mcer12/Flora-ESP8266/Resources/IV-6_V2_SCHEMATIC.pdf

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
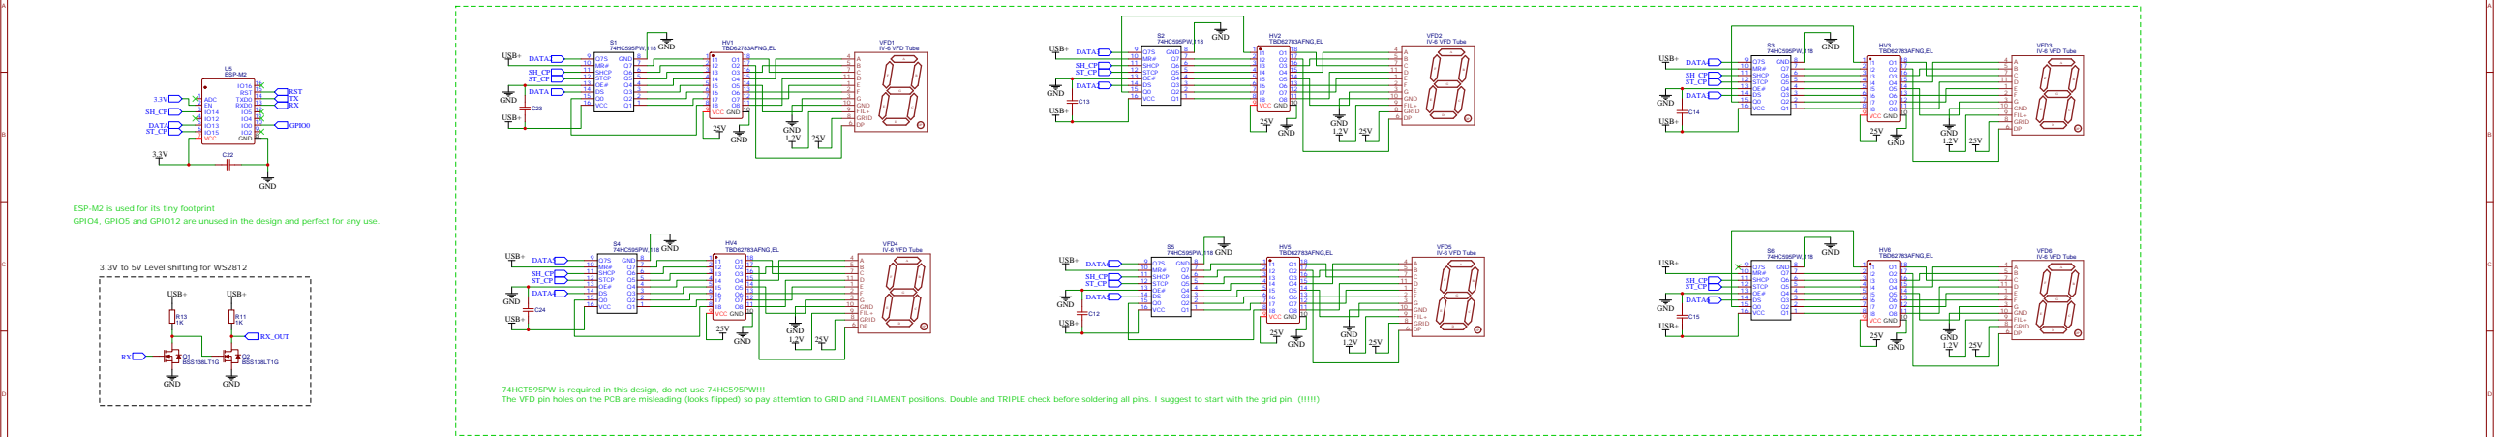
[picture p7: figure]
GND 1.2V; USB+; GND; DATA; DATA2 USB+; DATA2; DATA3; DATA4; DATA5 USB+; DATA5; DATA6; IV-6 VFD Tube; VFD1; FIL+; GRID; VFD2; VFD3; VFD4; VFD5; VFD6; ESP-M2; ADC 1 EN 2 IO14 3 IO12 4 IO13 5 IO15 6; VCC 7; GND 8; GPIO0; RST; ESP-M2 is used for its tiny footprint; TBD62783AFNG,EL; VCC; GND 8 Q7S 9 MR# 10 SHCP 11 STCP 12 OE# 13 DS 14 Q0 15 VCC 16; SHCP; STCP; 3.3V to 5V Level shifting for WS2812; BSS138LT1G; RX_OUT

IO0 10 IO4 11 IO5 12 RXD0 13 TXD0 14 RST 15

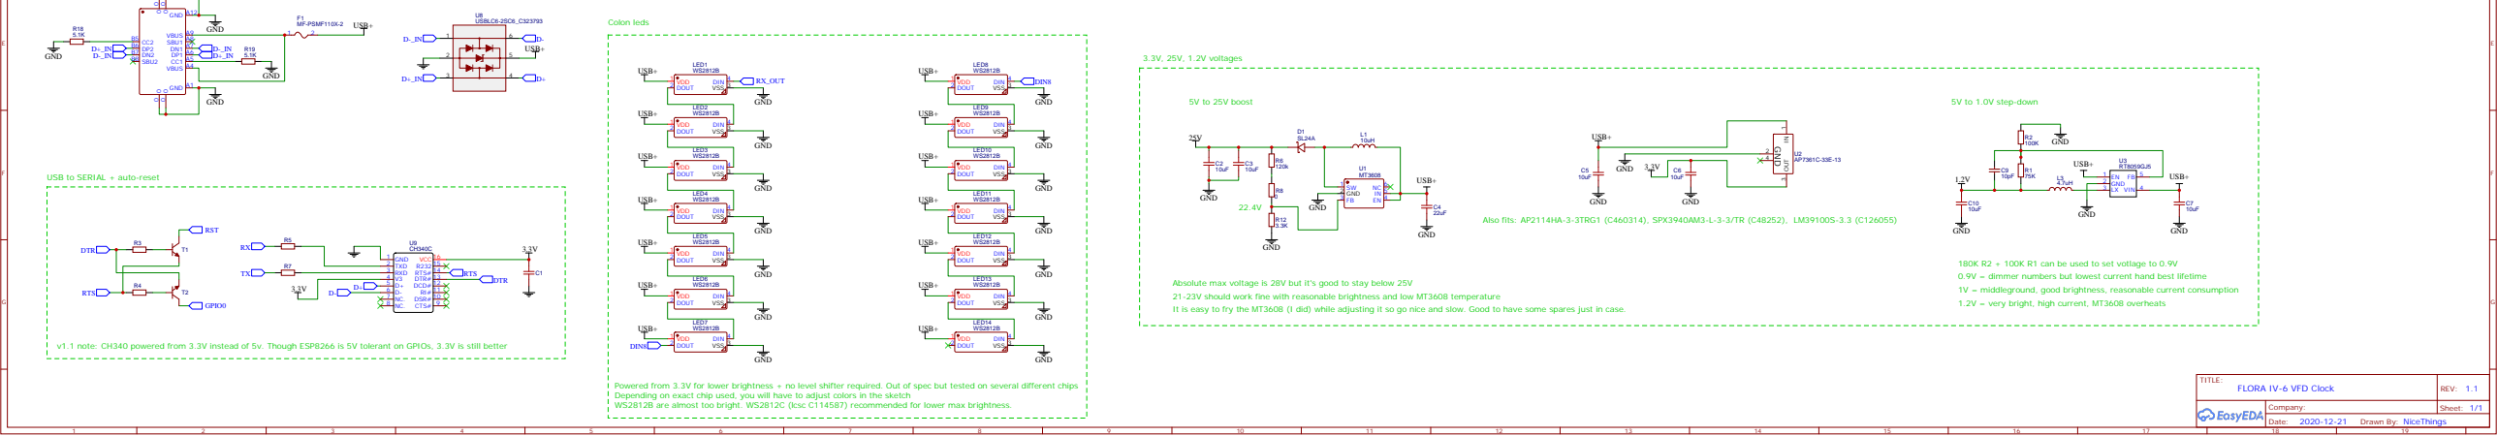
[picture p8: figure]
TITLE:; FLORA IV-6 VFD Clock; REV: 1.1; Date:; Sheet: 1/1 Drawn By: NiceThings; Company:; LED1; DIN; VSS; 3 DOUT; VDD; LED2; LED3; LED4; LED5; GND; VIN; RST; GPIO0; DTR; RTS; USB to SERIAL + auto-reset; VCC 16 R232 15 RTS# 14 DTR# 13 DCD# 12 RI# 11 DSR# 10 CTS# 9 NC. 8; RXD 3; TXD 2; GND 1; 5V to 1.0V step-down; USB+; LED6; 3.3V, 25V, 1.2V voltages; USB+ 1.2V; 5V to 25V boost; DIN8; Colon leds; CC2 B5 DP2 B6 DN2 B7 SBU2 B8; GND A1; GND A12; MF-PSMF110X-2; USBLC6-2SC6_C323793; D- USB+; LED7; LED8; LED9; LED10; LED11; LED12; LED13; LED14; RX_OUT; OUT

## Absolute max voltage is 28V but it's good to stay below 25V 21-23V should work fine with reasonable brightness and low MT3608 temperature

It is easy to fry the MT3608 (I did) while adjusting it so go nice and slow. Good to have some spares just in case.

The VFD pin holes on the PCB are misleading (looks flipped) so pay attemtion to GRID and FILAMENT positions. Double and TRIPLE check before soldering all pins. I suggest to start with the grid pin. (!!!!!)

## VFD + shift registers

## 180K R2 + 100K R1 can be used to set votlage to 0.9V

WS2812B are almost too bright. WS2812C (lcsc C114587) recommended for lower max brightness.

## Depending on exact chip used, you will have to adjust colors in the sketch

GPIO4, GPIO5 and GPIO12 are unused in the design and perfect for any use.

v1.1 note: CH340 powered from 3.3V instead of 5v. Though ESP8266 is 5V tolerant on GPIOs, 3.3V is still better

Powered from 3.3V for lower brightness + no level shifter required. Out of spec but tested on several different chips

## 0.9V = dimmer numbers but lowest current hand best lifetime 1V = middleground, good brightness, reasonable current consumption 1.2V = very bright, high current, MT3608 overheats

USB3.1C16PFSMT

USBC1

VBUS A4 CC1 A5 DP1 A6 DN1 A7 SBU1 A8 VBUS A9

Also fits: AP2114HA-3-3TRG1 (C460314), SPX3940AM3-L-3-3/TR (C48252), LM39100S-3.3 (C126055)

## 74HCT595PW is required in this design, do not use 74HC595PW!!!
