mcer12/Flora-ESP8266/Resources/IV-12_SCHEMATIC.pdf

1

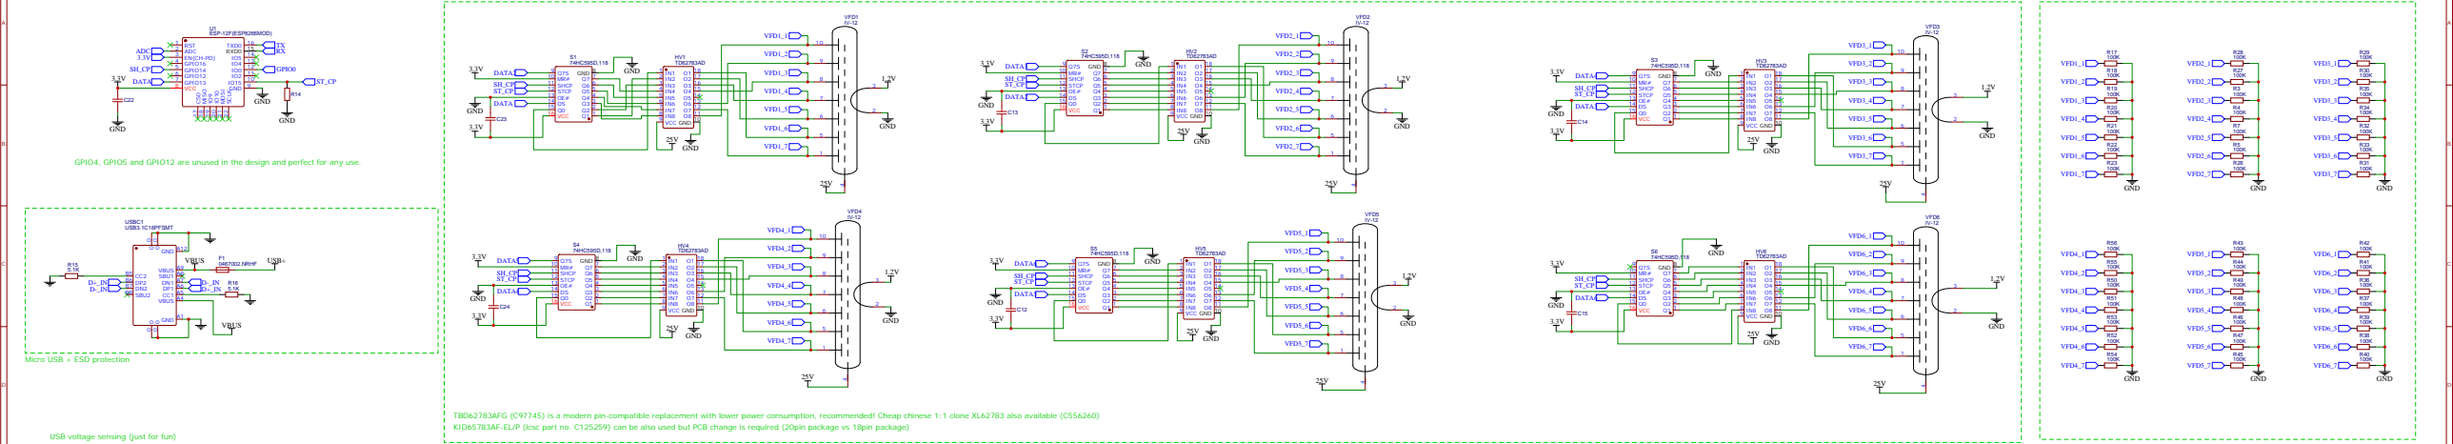
[picture p9: figure]
GND 8 Q7S 9 MR# 10 SHCP 11 STCP 12 OE# 13 DS 14 Q0 15 VCC 16; Micro USB + ESD protection; GND; SHCP; STCP; VCC; DATA; DATA2 3.3V; DATA2; DATA3; DATA4; DATA5 3.3V; DATA5; DATA6; O1 GND; VFD2; VFD1; VFD4; VFD5; VFD6; VFD3; ESP-12F(ESP8266MOD); RST 1 ADC 2 EN(CH-PD) 3 GPIO16 4 GPIO14 5 GPIO12 6 GPIO13 7; VCC 8; GND 9; MISO 18 IO9 19; MOSI 21 SCLK 22; GPIO0; VBUS; USB+; VFD3_1; VFD3_2; VFD3_3; VFD3_4; VFD3_5; VFD3_6; VFD3_7; ADC; USB voltage sensing (just for fun); VFD6_1; VFD6_2; VFD6_3; VFD6_4; VFD6_5; VFD6_6; VFD6_7; VFD5_1; VFD5_2; VFD5_3; VFD5_4; VFD5_5; VFD5_6; VFD5_7; VFD2_1; VFD2_2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
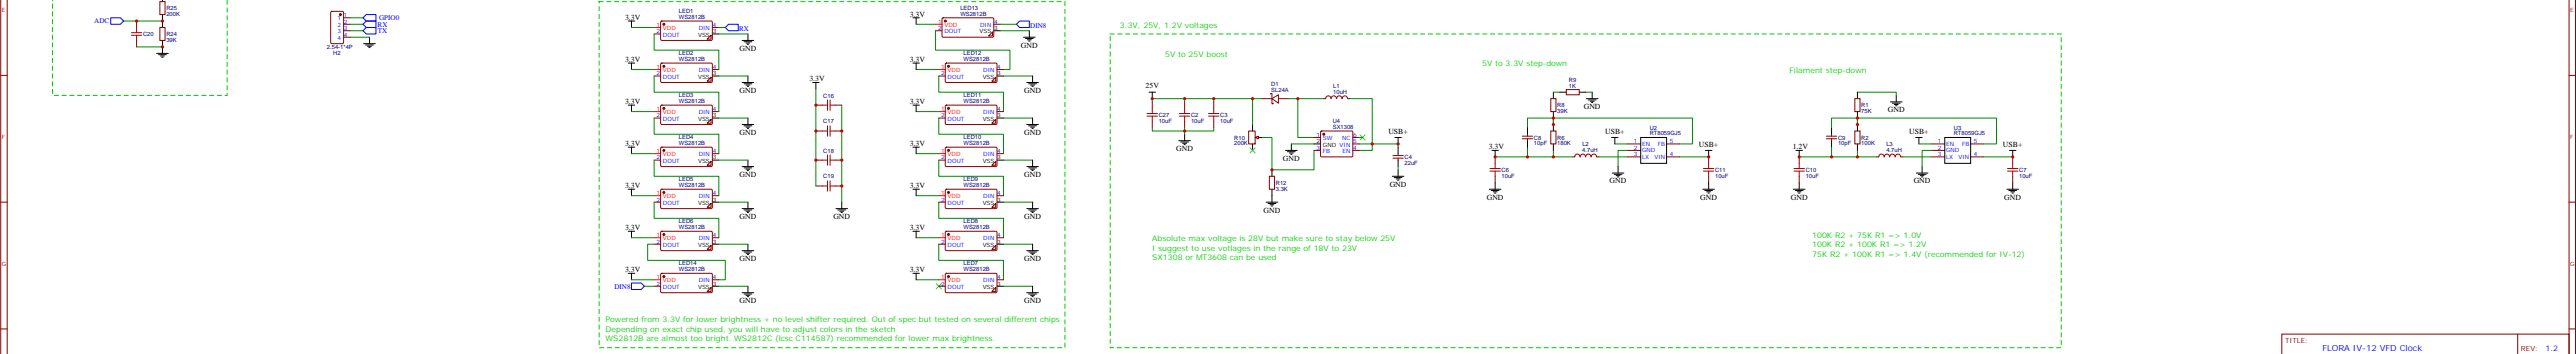
[picture p10: figure]
TITLE:; FLORA IV-12 VFD Clock; REV: 1.2; LED1; DIN; VSS; 3 DOUT; VDD; LED2; LED3; LED4; LED5; GND; VIN; Filament step-down; 5V to 3.3V step-down; LED6; USB+; 3.3V, 25V, 1.2V voltages; USB+ 1.2V; 5V to 25V boost; LED7; LED8; LED9; LED10; LED11; LED12; SX1308 or MT3608 can be used; ADC; GPIO0; DIN8; LED13; LED14

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
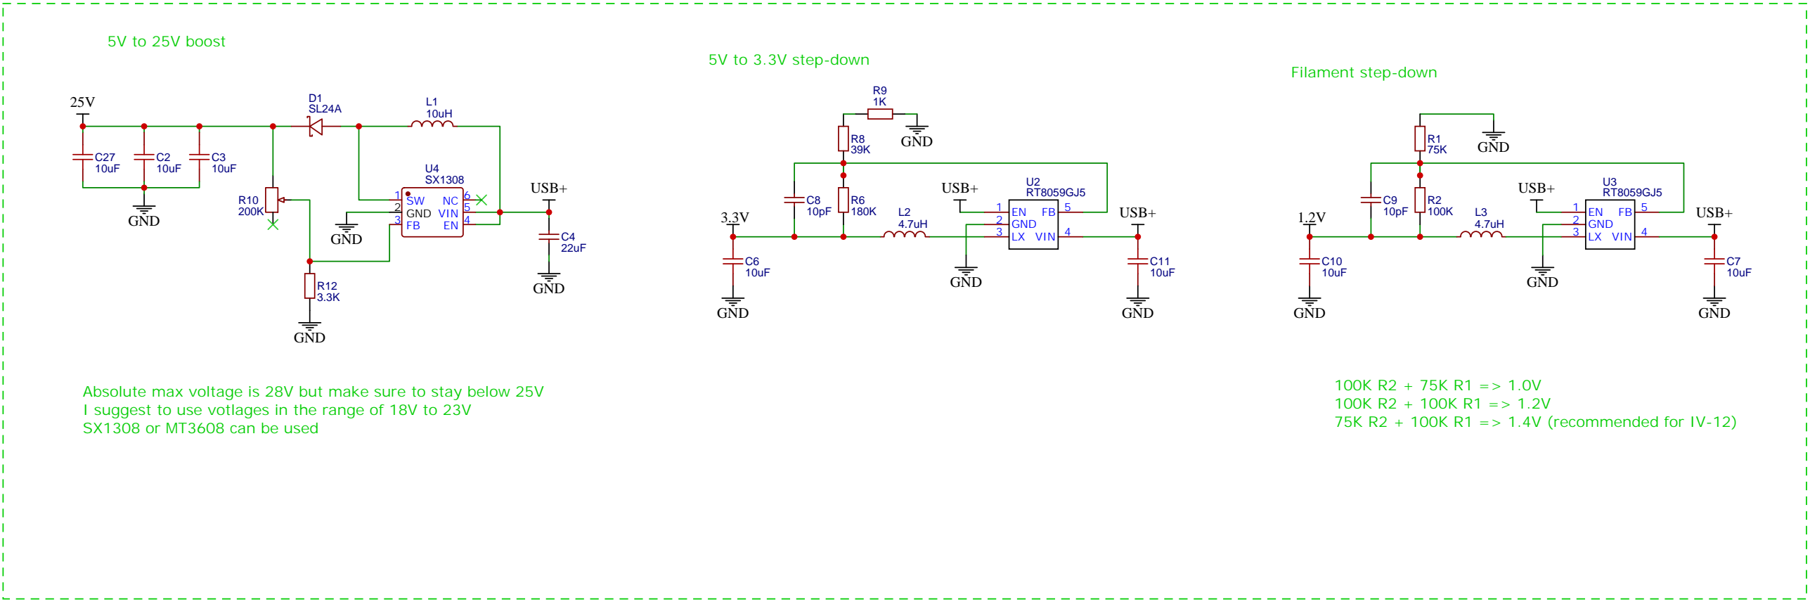
[picture p11: figure]

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
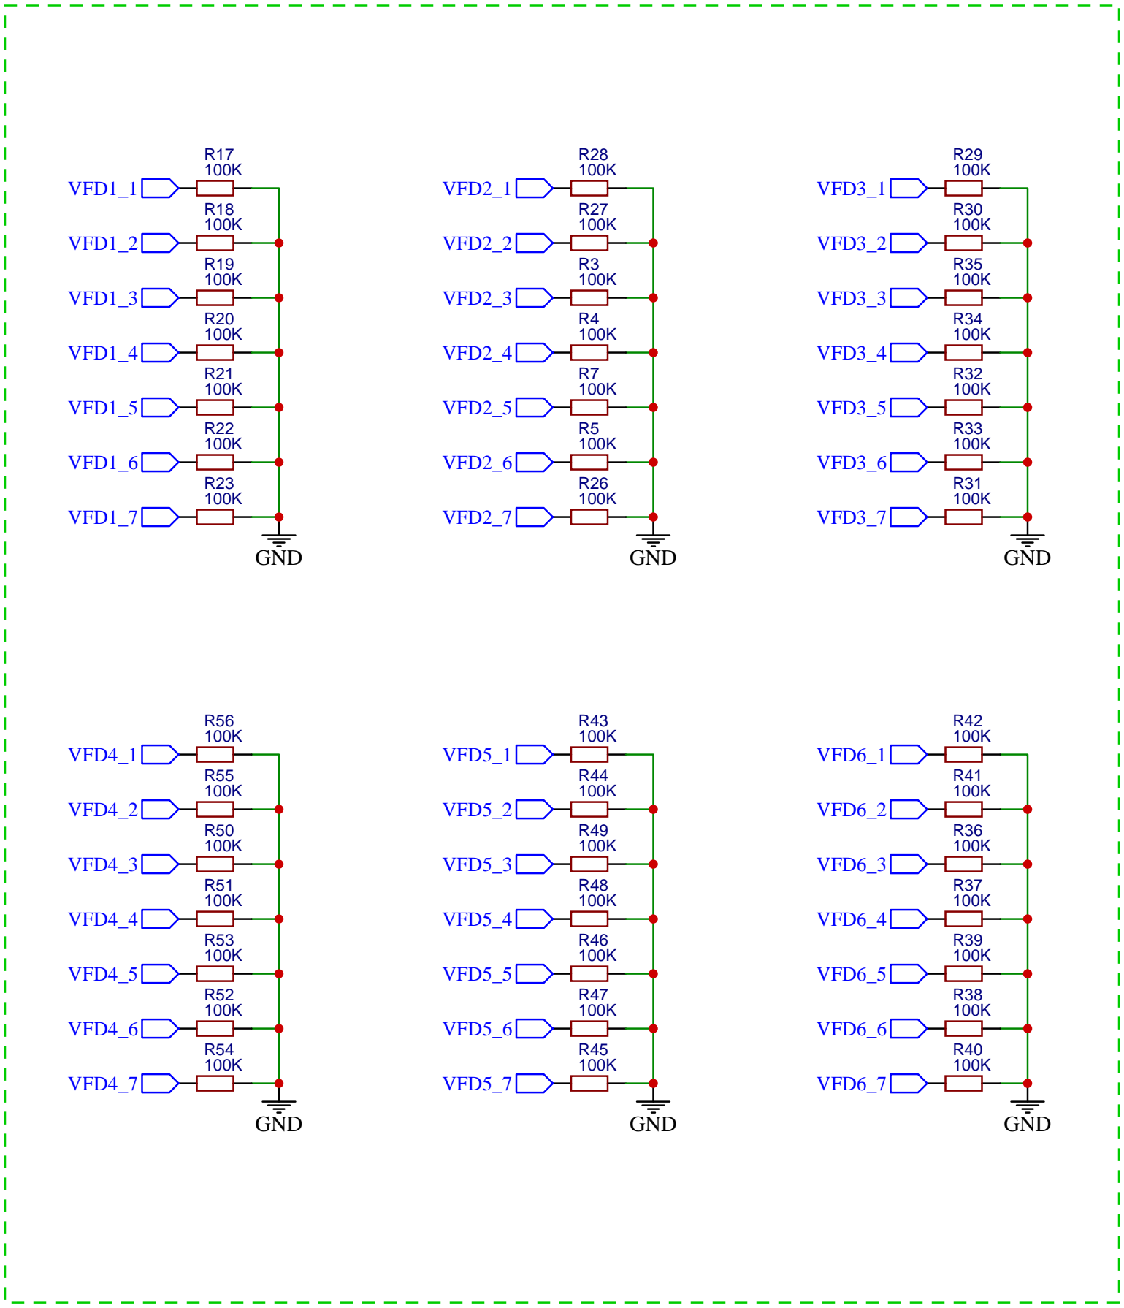
[picture p12: figure]

18

19

19

20

20

## Date: 2020-03-14

### Sheet: 1/1

## Drawn By: NiceThings

### Company:

## Colon leds

## VFD + shift registers

WS2812B are almost too bright. WS2812C (lcsc C114587) recommended for lower max brightness.

## Depending on exact chip used, you will have to adjust colors in the sketch

GPIO4, GPIO5 and GPIO12 are unused in the design and perfect for any use.

Powered from 3.3V for lower brightness + no level shifter required. Out of spec but tested on several different chips

## Absolute max voltage is 28V but make sure to stay below 25V I suggest to use votlages in the range of 18V to 23V 75K R2 + 100K R1 => 1.4V (recommended for IV-12)

IO15 10 IO2 11 IO0 12 IO4 13 IO5 14 RXD0 15 TXD0 16

KID65783AF-EL/P (lcsc part no. C125259) can be also used but PCB change is required (20pin package vs 18pin package)

TBD62783AFG (C97745) is a modern pin-compatible replacement with lower power consumption, recommended! Cheap chinese 1:1 clone XL62783 also available (C556260)

## Pulldown resistors, solder only for segments that don't turn fully off to save power

### USB+

VBUS A4 CC1 A5 DP1 A6 DN1 A7 SBU1 A8 VBUS A9
