mcer12/Flora-ESP8266/Resources/IV-22_V2_SCHEMATIC.pdf

1

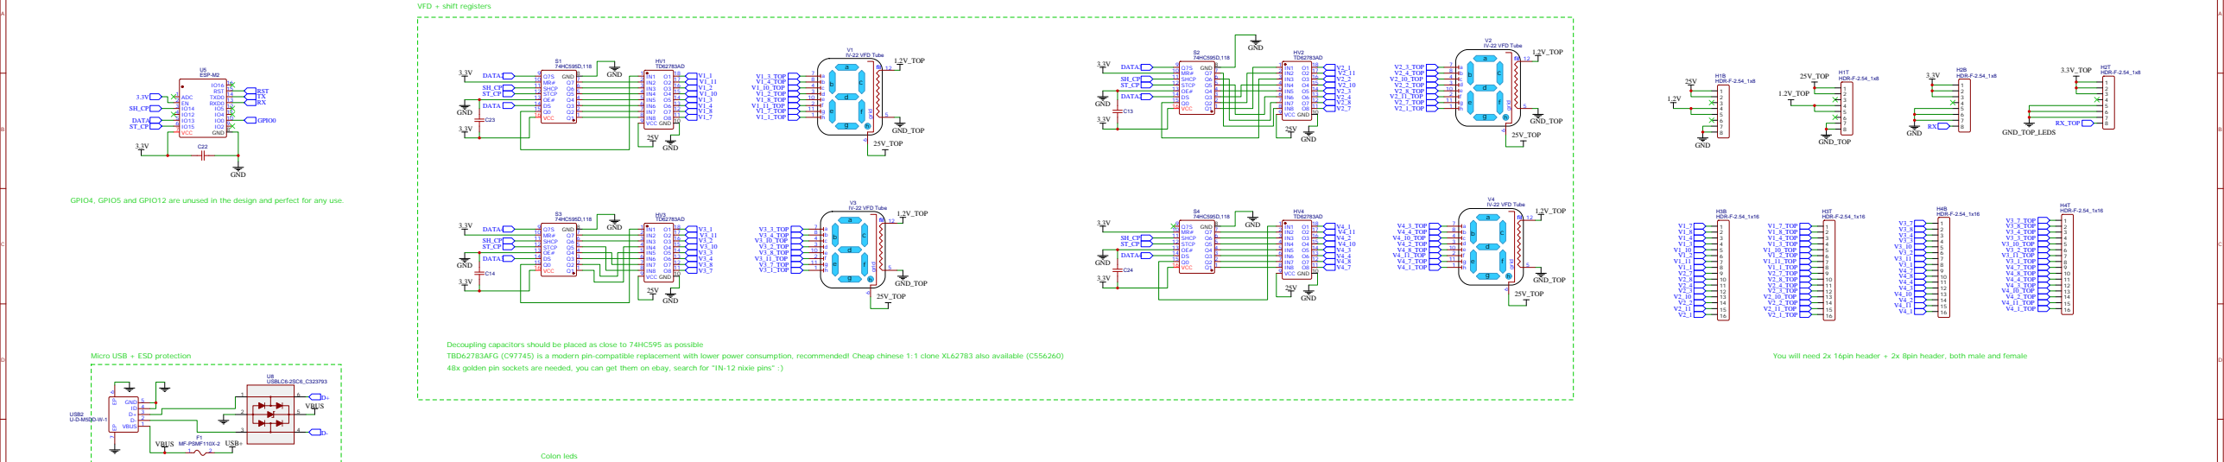
[picture p13: figure]
GND 8 Q7S 9 MR# 10 SHCP 11 STCP 12 OE# 13 DS 14 Q0 15 VCC 16; USBLC6-2SC6_C323793; Micro USB + ESD protection; USB+; GND; SHCP; STCP; VCC; DATA; DATA2 3.3V; DATA2; DATA3; DATA4 3.3V; DATA4; Colon leds; MF-PSMF110X-2; ESP-M2; ADC 1 EN 2 IO14 3 IO12 4 IO13 5 IO15 6; VCC 7; GND 8; GPIO0; RST; O1 GND; VBUS; 25V_TOP; 1.2V_TOP; GND_TOP; VFD + shift registers; IV-22 VFD Tube; grid; fil 12; USB2; VBUS 1; GND 5; HDR-F-2.54_1x8; HDR-F-2.54_1x16; V1_1_TOP; V1_11_TOP; V1_2_TOP; V1_10_TOP; V1_3_TOP; V1_8_TOP; V1_4_TOP; V1_7_TOP; V2_1_TOP; V2_11_TOP; V2_2_TOP; V2_10_TOP; V2_3_TOP; V2_4_TOP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
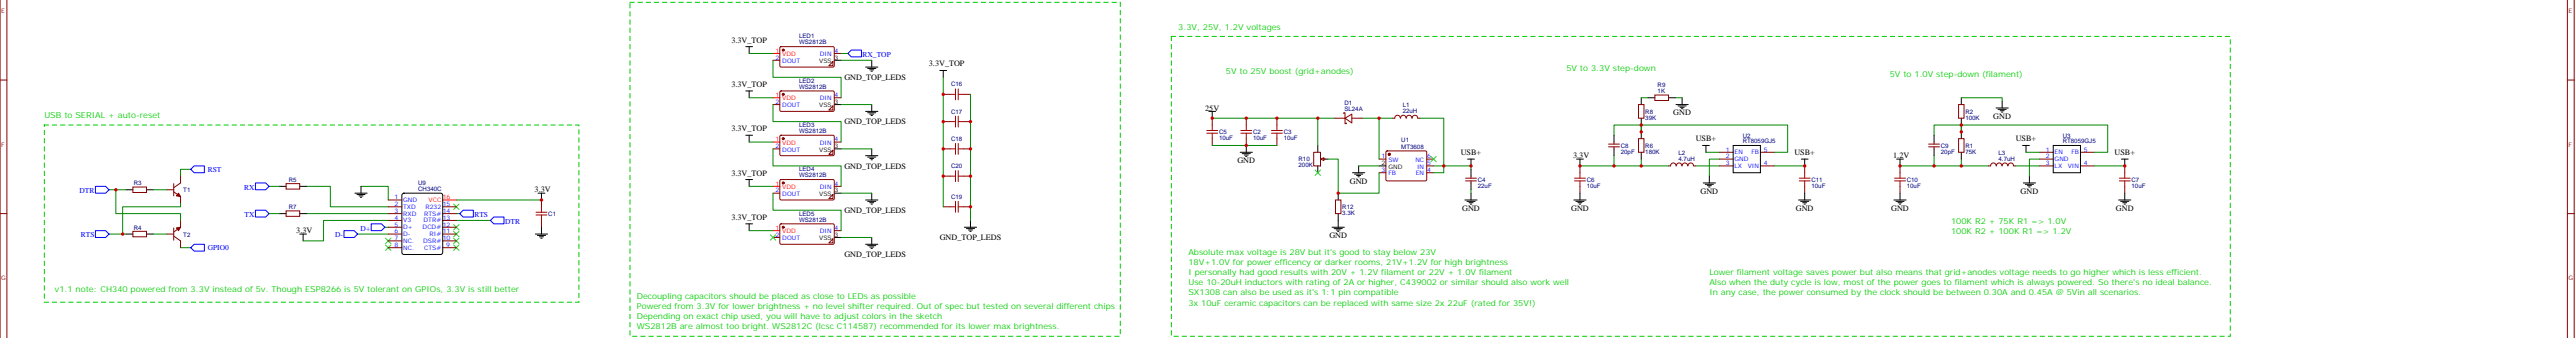
[picture p14: figure]
LED1; DIN; VSS; 3 DOUT; VDD; LED2; LED3; LED4; LED5; GND; VIN; RST; GPIO0; DTR; RTS; USB to SERIAL + auto-reset; VCC 16 R232 15 RTS# 14 DTR# 13 DCD# 12 RI# 11 DSR# 10 CTS# 9 NC. 8; RXD 3; TXD 2; GND 1; 5V to 1.0V step-down (filament); 5V to 3.3V step-down; 3.3V_TOP; GND_TOP_LEDS; RX_TOP; USB+; 3.3V, 25V, 1.2V voltages; USB+ 1.2V; 5V to 25V boost (grid+anodes)

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
TITLE:
FLORA IV-22 VFD Clock | REV: 2.0
Date: | 2021-03-09

Sheet: 1/1
Drawn By: NiceThings

Company:

IO0 10 IO4 11 IO5 12 RXD0 13 TXD0 14 RST 15

WS2812B are almost too bright. WS2812C (lcsc C114587) recommended for its lower max brightness.

Depending on exact chip used, you will have to adjust colors in the sketch

GPIO4, GPIO5 and GPIO12 are unused in the design and perfect for any use.

v1.1 note: CH340 powered from 3.3V instead of 5v. Though ESP8266 is 5V tolerant on GPIOs, 3.3V is still better Powered from 3.3V for lower brightness + no level shifter required. Out of spec but tested on several different chips

Absolute max voltage is 28V but it's good to stay below 23V
18V+1.0V for power efficency or darker rooms, 21V+1.2V for high brightness

Use 10-20uH inductors with rating of 2A or higher, C439002 or similar should also work well

TBD62783AFG (C97745) is a modern pin-compatible replacement with lower power consumption, recommended! Cheap chinese 1:1 clone XL62783 also available (C556260) | You will need 2x 16pin header + 2x 8pin header, both male and female
48x golden pin sockets are needed, you can get them on ebay, search for "IN-12 nixie pins" :)

I personally had good results with 20V + 1.2V filament or 22V + 1.0V filament

SX1308 can also be used as it's 1:1 pin compatible

Lower filament voltage saves power but also means that grid+anodes voltage needs to go higher which is less efficient. Also when the duty cycle is low, most of the power goes to filament which is always powered. So there's no ideal balance. In any case, the power consumed by the clock should be between 0.30A and 0.45A @ 5Vin all scenarios.

Decoupling capacitors should be placed as close to 74HC595 as possible

Decoupling capacitors should be placed as close to LEDs as possible 3x 10uF ceramic capacitors can be replaced with same size 2x 22uF (rated for 35V!)
