mcer12/Flora-ESP8266/Images/clock.jpg

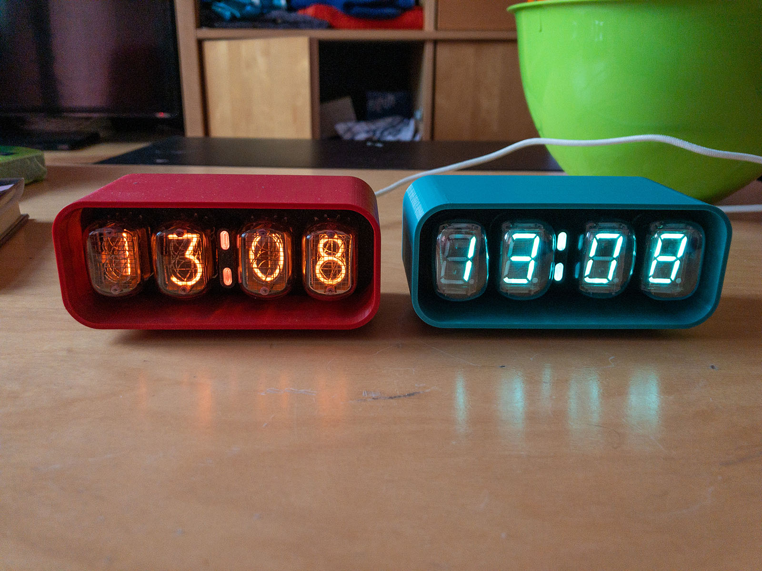
Images/clock.jpg
