mcer12/Flora-ESP8266/Images/IV22_colon_blind.jpg

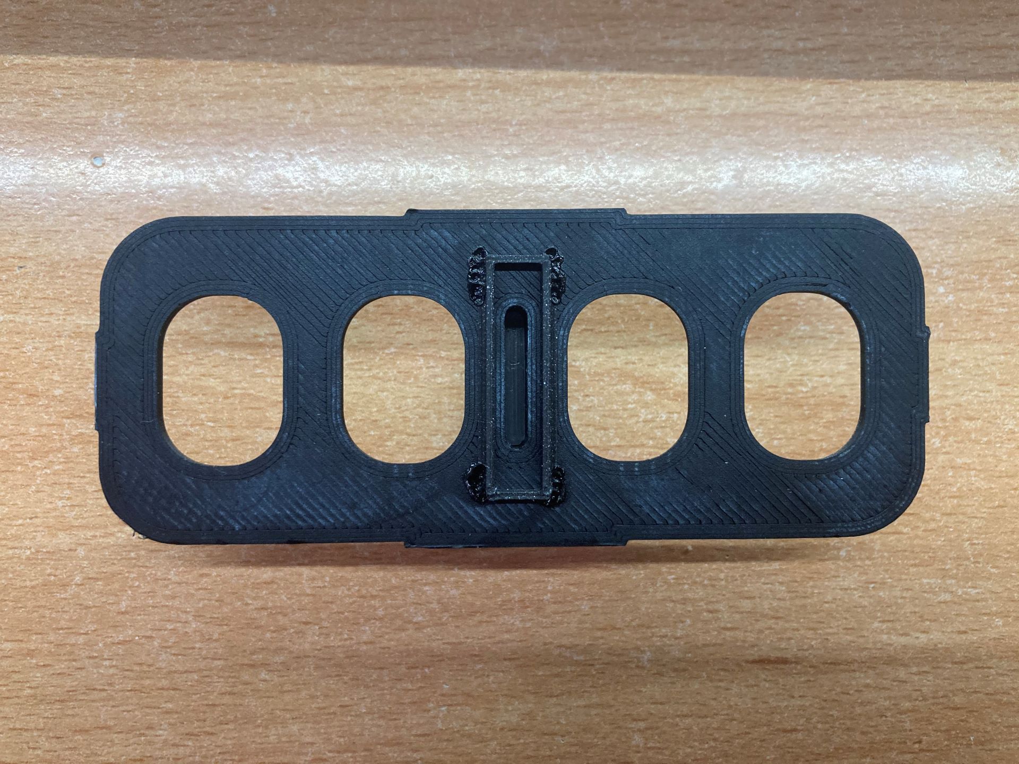
Images/IV22_colon_blind.jpg
