mcer12/Flora-ESP8266/Images/pcb_bottom.jpg

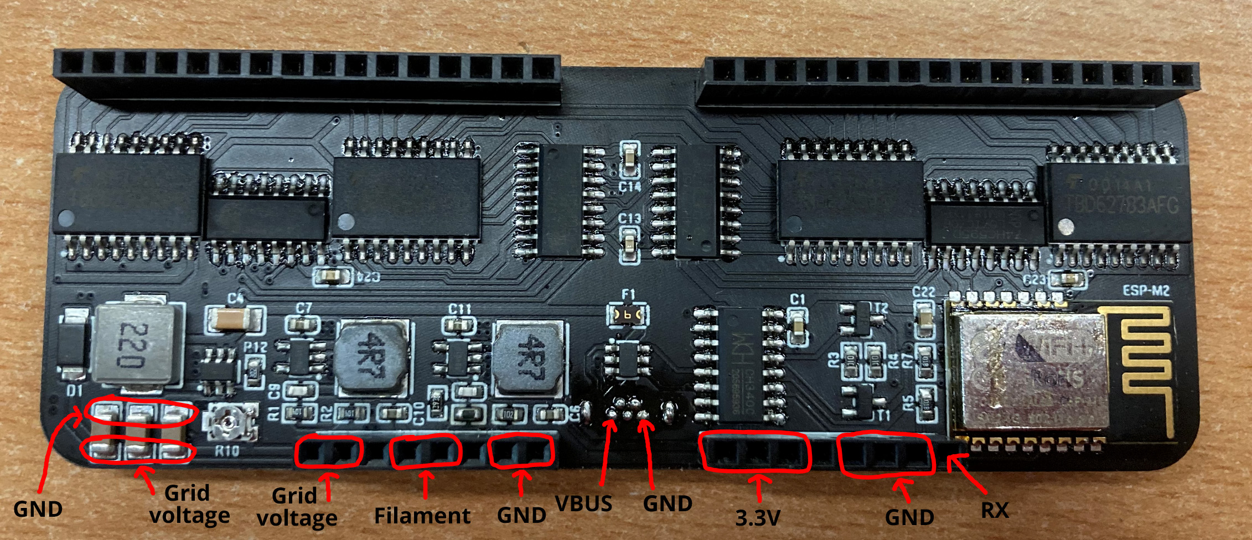
Images/pcb_bottom.jpg
