mcer12/Flora-ESP8266/Images/pcb_top.jpg

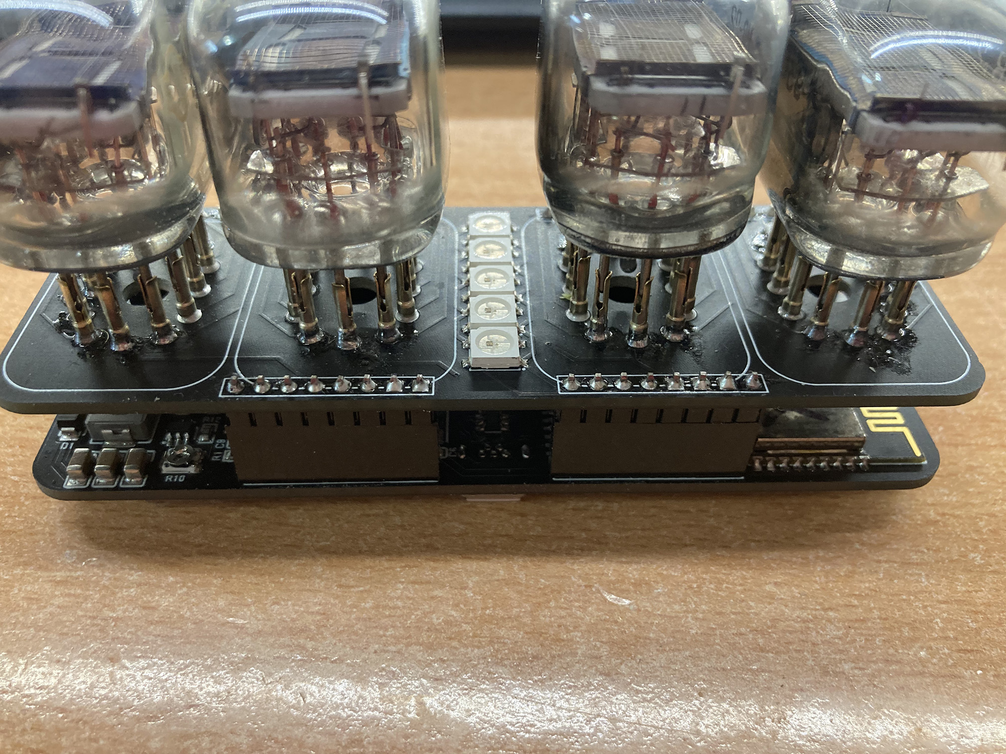
Images/pcb_top.jpg
