mcer12/Flora-ESP8266/Resources/IV-3_BOM.csv

ID | Name | Designator | Footprint | Quantity | Manufacturer Part | Manufacturer | Supplier | Supplier Part | Price
1 | 10kΩ | R11,R13,R14,R15,R16,R17,R20,R21,R22,R23,R24,R25 | R0603 | 12 | 0603WAF1002T5E | UniOhm | LCSC | C25804
2 | IV3VFD | VFD2,VFD3,VFD4,VFD5,VFD6,VFD1 | IV-3 | 6
3 | 100nF | C1,C12,C13,C14,C15,C22,C23,C24 | C0603 | 8 | CC0603KRX7R9BB104 | YAGEO | LCSC | C14663
4 | WS2812B | LED13,LED14,LED1,LED2,LED3,LED4,LED5,LED6,LED7,LED8,LED9,LED10,LED11,LED12 | LED-SMD_4P-L5.0-W5.0-TL | 14 | WS2812B | Worldsemi | LCSC | C114585
5 | MF-PSMF110X-2 | F1 | F0805 | 1 | MF-PSMF110X-2 | BOURNS | LCSC | C89658 | 0.005
6 | 5.1K | R18,R19 | R0603 | 2 | 0603WAF5101T5E | UniOhm | LCSC | C23186
7 | USB3.1C16PFSMT | USBC1 | USB-C-SMD_TYPE-C-USB-17 | 1 | - | LCSC | LCSC | C167321 | 0.059
8 | TBD62783AFNG,EL | HV1,HV2,HV3,HV4,HV5,HV6 | SSOP-18_L6.8-W4.4-P0.65-LS6.4-BL | 6 | TBD62783AFNG,EL | TOSHIBA(东芝) | LCSC | C2653777 | 0.459
9 | 74HCT595PW,118 | S1,S2,S3,S4,S5,S6 | TSSOP-16_L5.0-W4.4-P0.65-LS6.4-BL | 6 | 74HCT595PW,118 | Nexperia | LCSC | C99710 | 0.028
10 | 200K | R10 | RES-ADJ-SMD_VG039NCH | 1 | VG039NCHXTB204 | HDK | LCSC | C128551 | 0.013
11 | MT3608 | U1 | SOT-23-6_L2.9-W1.6-P0.95-LS2.8-BR | 1 | MT3608 | AEROSEMI | LCSC | C84817 | 0.014
12 | RT8059GJ5 | U2,U3 | SOT-23-5_L3.0-W1.7-P0.95-LS2.8-BR | 2 | RT8059GJ5 | RICHTEK | LCSC | C20542 | 0.029
13 | SL24A | D1 | SMA_L4.4-W2.8-LS5.4-RD | 1 | SL24A | Suzhou Good-Ark Elec | LCSC | C179543 | 0.015
14 | 10uF | C2,C3 | C1206 | 2 | CL31B106KBHNNNE | SAMSUNG | LCSC | C89632 | 0.009
15 | 22uF | C4 | C1206 | 1 | CL31A226KPHNNNE | SAMSUNG | LCSC | C5672 | 0.004
16 | 3.3K | R12 | R0603 | 1 | 0603WAF3301T5E | UniOhm | LCSC | C22978
17 | 75K | R1 | R0603 | 1 | 0603WAF7502T5E | UniOhm | LCSC | C23242
18 | 10uH | L1 | IND-SMD_L6.0-W6.0 | 1 | CR6028-100M | Ceaiya | LCSC | C520365 | 0.009
19 | 100K | R2 | R0603 | 1 | 0603WAF1003T5E | UniOhm | LCSC | C25803
20 | CH340C | U9 | SOP-16_L10.0-W3.9-P1.27-LS6.0-BL | 1 | CH340C | WCH | LCSC | C84681 | 0.077
21 | USBLC6-2SC6_C323793 | U8 | SOT-23-6_L2.9-W1.6-P0.95-LS2.8-BL | 1 | USBLC6-2SC6 | Yenji Elec | LCSC | C323793 | 0.013
22 | 1K | R9,R5,R7 | R0603 | 3 | 0603WAF1001T5E | UniOhm | LCSC | C21190
23 | 180K | R6 | R0603 | 1 | 0603WAF1803T5E | UniOhm | LCSC | C22827
24 | 10K | R4,R3 | R0603 | 2 | 0603WAF1002T5E | UniOhm | LCSC | C25804
25 | MMBT3904-C20526 | T2,T1 | SOT-23-3_L2.9-W1.3-P1.90-LS2.4-BR | 2 | MMBT3904 | CJ | LCSC | C20526 | 0.002
26 | 39K | R8 | R0603 | 1 | 0603WAF3902T5E | UniOhm | LCSC | C23153
27 | ESP-M2 | U5 | ESP-M2 | 1 | ESP-M2 | Ai-Thinker |  |  | 0.419
28 | 4.7uH | L2,L3 | IND-SMD_L6.0-W6.0 | 2 | CR6028-4R7N | Ceaiya | LCSC | C520369 | 0.009
29 | 10uF | C6,C7,C10,C11 | C0603 | 4 | CL10A106KP8NNNC | SAMSUNG | LCSC | C19702 | 0.001
30 | 10pF | C8,C9 | C0603 | 2 | CL10C100JB8NNNC | SAMSUNG | LCSC | C1634 | 0.001
