mcer12/Flora-ESP8266/Resources/IV-12_BOM.xlsx

ID | Name | Designator | Footprint | Quantity | Manufacturer Part | Manufacturer | Supplier | Supplier Part | Price | LCSC Assembly | JLCPCB SMD | Paste Type | JLCPCB Part Class
1 | 10uF | C2,C3,C27 | C1206 | 3 | CL31B106KBHNNNE | SAMSUNG | LCSC | C89632 |  |  | Yes
2 | 22uF | C4 | C1206 | 1 | CL31A226KPHNNNE | SAMSUNG | LCSC | C5672 |  |  | Yes
3 | 10uF | C6,C7,C10,C11 | C0603 | 4 | CL10A106KP8NNNC | SAMSUNG | LCSC | C19702 |  | Yes
4 | 10pF | C8,C9 | C0603 | 2 | CL10C100JB8NNNC | SAMSUNG | LCSC | C1634 |  | Yes
5 | 100nF | C12,C13,C14,C15,C16,C17,C18,C19,C20,C22,C23,C24 | C0603 | 12 | CC0603KRX7R9BB104 | YAGEO | LCSC | C14663 |  | Yes
6 | SL24A | D1 | SMA_L4.4-W2.8-LS5.4-RD | 1 | SL24A | Suzhou Good-Ark Elec | LCSC | C179543 |  | Yes | Yes
7 | 0467002.NRHF | F1 | F0603 | 1 | 0467002.NRHF | Littelfuse | LCSC | C187605 |  |  | Yes | recommend
8 | 2.54-1*4P | H2 | HDR-TH_4P-P2.54-H-M-W10.4 | 1 | 2.54-1*4P反弯排针 | BOOMELE(博穆精密) | LCSC | C91552 |  |  |  |  | Extended Part
9 | TD62783AD | HV1,HV2,HV3,HV4,HV5,HV6 | SOIC-18_L11.6-W7.5-P1.27-LS10.3-BL | 6 | TD62783AD | HTC Korea TAEJIN Tech | LCSC | C699444
10 | 10uH | L1 | IND-SMD_L8.0-W8.0_SMNR8040 | 1 | CR8040-100M | Ceaiya | LCSC | C520371
11 | 4.7uH | L2,L3 | IND-SMD_L6.0-W6.0 | 2 | CR6028-4R7N | Ceaiya | LCSC | C520369
12 | WS2812B | LED1,LED2,LED3,LED4,LED5,LED6,LED7,LED8,LED9,LED10,LED11,LED12,LED13,LED14 | LED-SMD_4P-L5.0-W5.0-TL | 14 | WS2812B | Worldsemi | LCSC | C114585
13 | 75K | R1 | R0603 | 1 | 0603WAF7502T5E | UniOhm | LCSC | C23242 |  |  | Yes
14 | 100K | R2 | R0603 | 1 | 0603WAF1003T5E | UniOhm | LCSC | C25803 |  | Yes
15 | 180K | R6 | R0603 | 1 | 0603WAF1803T5E | UniOhm | LCSC | C22827 |  | Yes
16 | 39K | R8 | R0603 | 1 | 0603WAF3902T5E | UniOhm | LCSC | C23153 |  | Yes
17 | 1K | R9 | R0603 | 1 | 0603WAF1001T5E | UniOhm | LCSC | C21190 |  | Yes
18 | 200K | R10 | RES-ADJ-SMD_VG039NCH | 1 | VG039NCHXTB204 | HDK | LCSC | C128551
19 | 3.3K | R12 | R0603 | 1 | 0603WAF3301T5E | UniOhm | LCSC | C22978 |  |  | Yes
20 | 10K | R14 | R0603 | 1 | 0603WAF1002T5E | UniOhm | LCSC | C25804 |  | Yes
21 | 5.1K | R15,R16 | R0603 | 2 | 0603WAF5101T5E | UniOhm | LCSC | C23186 |  | Yes | Yes
22 | 100K | R3,R4,R5,R7,R17,R18,R19,R20,R21,R22,R23,R26,R27,R28,R29,R30,R31,R32,R33,R34,R35,R36,R37,R38,R39,R40,R41,R42,R43,R44,R45,R46,R47,R48,R49,R50,R51,R52,R53,R54,R55,R56 | R0603 | 42 | 0603WAF1003T5E | UniOhm | LCSC | C25803 |  | Yes | Yes | base
23 | 39K | R24 | R0603 | 1 | 0603WAF3902T5E | UniOhm | LCSC | C23153 |  | Yes | Yes | base
24 | 200K | R25 | R0603 | 1 | 0603WAF2003T5E | UniOhm | LCSC | C25811 |  | Yes | Yes | base
25 | 74HC595D,118 | S1,S2,S3,S4,S5,S6 | SOIC-16_L9.9-W3.9-P1.27-LS6.0-BL | 6 | 74HC595D,118 | Nexperia | LCSC | C5947 |  | Yes
26 | ESP-12F(ESP8266MOD) | U1 | WIFIM-SMD_ESP-12F-ESP8266MOD | 1 | ESP-12F(ESP8266MOD) | Ai-Thinker | LCSC | C82891
27 | RT8059GJ5 | U2,U3 | SOT-23-5_L3.0-W1.7-P0.95-LS2.8-BR | 2 | RT8059GJ5 | RICHTEK | LCSC | C20542 |  | Yes
28 | SX1308 | U4 | SOT-23-6_L2.9-W1.6-P0.95-LS2.8-BR | 1 | SX1308 | SX | LCSC | C78162 |  |  | Yes
29 | USB3.1C16PFSMT | USBC1 | USB-C-SMD_TYPE-C-USB-17 | 1 | - | LCSC | LCSC | C167321 |  |  |  | Extended Part | Extended Part
30 | IV-12 | VFD1,VFD2,VFD3,VFD4,VFD5,VFD6 | IV-12 | 6 | IV-12 | USSR
