mcer12/Flora-ESP8266/Resources/IV-22_V2_BOM.xlsx

ID | Name | Designator | Footprint | Quantity | Manufacturer Part | Manufacturer | Supplier | Supplier Part | LCSC Assembly | JLCPCB SMD | Assembly Type | Paste Type
1 | 10uF | C2,C3,C5 | C1206 | 3 | CL31B106KBHNNNE | SAMSUNG | LCSC | C89632 |  | Yes
2 | 22uF | C4 | C1206 | 1 | CL31A226KPHNNNE | SAMSUNG | LCSC | C5672 |  | Yes
3 | 10uF | C6,C7,C10,C11 | C0603 | 4 | CL10A106KP8NNNC | SAMSUNG | LCSC | C19702 | Yes
4 | 20pF | C8,C9 | C0603 | 2 | CL10C200JB8NNNC | SAMSUNG | LCSC | C1648 | Yes | Yes | smtWeld | base
5 | 100nF | C1,C13,C14,C16,C17,C18,C19,C20,C22,C23,C24 | C0603 | 11 | CC0603KRX7R9BB104 | YAGEO | LCSC | C14663 | Yes
6 | SL24A | D1 | SMA_L4.4-W2.8-LS5.4-RD | 1 | SL24A | Suzhou Good-Ark Elec | LCSC | C179543 | Yes | Yes
7 | MF-PSMF110X-2 | F1 | F0805 | 1 | MF-PSMF110X-2 | BOURNS | LCSC | C89658 | Yes
10 | TD62783AD | HV1,HV2,HV3,HV4 | SOIC-18_L11.6-W7.5-P1.27-LS10.3-BL | 4 | TD62783AD | HTC Korea TAEJIN Tech | LCSC | C699444
11 | 22uH | L1 | IND-SMD_L7.1-W6.6 | 1 | YSPI0630A-220M | YJYCOIN | LCSC | C497873
12 | 4.7uH | L2,L3 | IND-SMD_L6.0-W6.0 | 2 | CR6028-4R7N | Ceaiya | LCSC | C520369
13 | WS2812B | LED1,LED2,LED3,LED4,LED5 | LED-SMD_4P-L5.0-W5.0-TL | 5 | WS2812B | Worldsemi | LCSC | C114585
14 | 75K | R1 | R0603 | 1 | 0603WAF7502T5E | UniOhm | LCSC | C23242 |  | Yes
15 | 100K | R2 | R0603 | 1 | 0603WAF1003T5E | UniOhm | LCSC | C25803 | Yes
16 | 10K | R3,R4 | R0603 | 2 | 0603WAF1002T5E | UniOhm | LCSC | C25804 | Yes
17 | 1K | R5,R7,R9 | R0603 | 3 | 0603WAF1001T5E | UniOhm | LCSC | C21190 | Yes
18 | 180K | R6 | R0603 | 1 | 0603WAF1803T5E | UniOhm | LCSC | C22827 | Yes
19 | 39K | R8 | R0603 | 1 | 0603WAF3902T5E | UniOhm | LCSC | C23153 | Yes
20 | 200K | R10 | RES-ADJ-SMD_VG039NCH | 1 | VG039NCHXTB204 | HDK | LCSC | C128551
21 | 3.3K | R12 | R0603 | 1 | 0603WAF3301T5E | UniOhm | LCSC | C22978 |  | Yes
22 | 74HC595D,118 | S1,S2,S3,S4 | SOIC-16_L9.9-W3.9-P1.27-LS6.0-BL | 4 | 74HC595D,118 | Nexperia | LCSC | C5947 | Yes
23 | MMBT3904-C20526 | T1,T2 | SOT-23-3_L2.9-W1.3-P1.90-LS2.4-BR | 2 | MMBT3904 | CJ | LCSC | C20526 | Yes
24 | MT3608 | U1 | SOT-23-6_L2.9-W1.6-P0.95-LS2.8-BR | 1 | MT3608 | AEROSEMI | LCSC | C84817 | Yes
25 | RT8059GJ5 | U2,U3 | SOT-23-5_L3.0-W1.7-P0.95-LS2.8-BR | 2 | RT8059GJ5 | RICHTEK | LCSC | C20542 | Yes
26 | ESP-M2 | U5 | ESP-M2 | 1 | ESP-M2 | Ai-Thinker
27 | USBLC6-2SC6_C323793 | U8 | SOT-23-6_L2.9-W1.6-P0.95-LS2.8-BL | 1 | USBLC6-2SC6 | Yenji Elec | LCSC | C323793 | Yes
28 | CH340C | U9 | SOP-16_L10.0-W3.9-P1.27-LS6.0-BL | 1 | CH340C | WCH | LCSC | C84681 | Yes
29 | U-D-M5DD-W-1 | USB2 | MICRO-USB-TH_MICRO-USB-A14 | 1 | U-D-M5DD-W-1 | HRO | LCSC | C145795
30 | HDR-F-2.54_1x8 | H1B,H2B | HDR-F-2.54_1X8 | 2 |  |  | LCSC | C225505
31 | HDR-F-2.54_1x16 | H3B,H4B | HDR-F-2.54_1X16 | 2 |  |  | LCSC | C66987
32 | HDR-M-2.54_1x8 |  |  | 2
33 | HDR-M-2.54_1x16 |  |  | 2
