mcer12/Flora-ESP8266/(threads)

Thread 1 (2021-03-06):

Separate brightness settings for each tube

mcer12, 2021-03-06:
This helps matching used tubes with different levels of burn-out.

mcer12, 2021-05-07:
Done.

Closed 2021-05-07.

Thread 3 (2021-03-08):

PWM phase shift

mcer12, 2021-03-08:
PWM is switching the high voltage current from quite high to zero very fast and this causes audible hum (on brightness below 100%). Shifting PWM cycle for each digit by few steps will smoothen the output current and help with transcient response of the booster. After this is implemented, the current should be pretty much the same throughout the duty cycle.

mcer12, 2021-03-18:
Done.

Closed 2021-03-18.

Thread 4 (2021-03-09):

Throwing exception at launch

geoffreyheller, 2021-03-09:
Cool project!

I have built the Flora 1.0 (yes I know there's a newer one coming, but I had already ordered the boards and parts earlier).  When I compile and upload the github code I get an exception thrown at launch.

I have narrowed this down to some problem with the NeoPixel strip library.  If I comment out all the strip calls, the wifi starts up and I get the website where I can configure the wifi ssid, password, and display information.

I am wondering if I am building with a different set of libraries than you?  Or perhaps my compile options are different than yours?

Can you please provide a list of the specific library versions you are using?

Here are my settings from the Arduino IDE:
Board: Generic ESP8285 Module
Builtin Led: 2
CPU Frequency: 80 Mhz
Crystal Freq: 26 Mhz
Flash size:  2MB (FS:64KB OTA~992KB)
Reset Method: dtr (aka nodemcu)
IwIP Variant: v2 Lower Memory
VTables: Flash
Exceptions: Legacy
SSL: All SSL ciphers (most compatible)

And here's the header for the exception I'm seeing on the serial monitor:
```
ets Jan  8 2013,rst cause:2, boot mode:(3,6)

load 0x4010f000, len 3584, room 16
tail 0
chksum 0xb0
csum 0xb0
v2843a5ac
~ld

SDK:2.2.2-dev(38a443e)/Core:2.7.3-3-g2843a5ac=20703003/lwIP:STABLE-2_1_2_RELEASE/glue:1.2-30-g92add50/BearSSL:5c771be
SPIFFSImpl: allocating 512+240+1400=2152 bytes
SPIFFSImpl: mounting fs @1f0000, size=b000, block=1000, page=100
SPIFFSImpl: mount rc=0

SPIFFS_close: fd=1
SPIFFS_close: fd=1
SETTINGS: No credentials set, going to config mode.
Fatal exception 0(IllegalInstructionCause):
epc1=0x40209268, epc2=0x00000000, epc3=0x00000000, excvaddr=0x00000000, depc=0x00000000

```
The above exception is thrown at line 30 of config_portal at the call to WiFi.mode(WIFI_AP);
Decoding the exception it appears to be a SPI error

One more Q:  Why is PixelCount set to 12 when there are five on the board?

Thank you!
-G.

mcer12, 2021-03-09:
Hi, first thing I see is that flash size is wrong, it should be 1M + 64SPIFFS for ESP-M2 (unless you designed your own board with different module ;) ) Another thing is that this sketch relies heavily on very fast timing, so definitely set CPU frequency to 160Mhz.
I use neopixel library 2.5.7, I will update to latest but I doubt that to be the culprit.

mcer12, 2021-03-09:
Pixel count is set to 12 because the 6 digit version has 12 leds :) The ESP has no way of knowing how many leds there really are so it doesn't make any difference.

geoffreyheller, 2021-03-09:
Ok I have set my flash size to 1M + 64SPIFFS as per the above and have also set the CPU freq to 160Mhz.

I am compiling with the following libraries:
NeoPixelBus by Makuna version 2.5.7
Time by Michael Margolis version 1.6.0
Ticker by Stefan Staub version 4.1.0
Timezone by Jack Christensen version 1.2.4 (note that this produces a compiler warning as it is targeted for AVR arch.  Possibly want to replace this with Timezone_Generic)

I am still seeing the exception happening.  Here's the exception decoded from the stack trace:

```
Exception 0: Illegal instruction
PC: 0x40209268: SPIClass::transfer(unsigned char) at C:\Users\Geoffrey\AppData\Local\Arduino15\packages\esp8266\hardware\esp8266\2.7.4\libraries\SPI\SPI.cpp line 308
EXCVADDR: 0x00000000

Decoding stack results
0x40220b0b: __swbuf_r at /home/earle/src/esp-quick-toolchain/repo/newlib/newlib/libc/stdio/wbuf.c line 82
0x401002cf: TimerHandler() at C:\Users\Geoffrey\Documents\PlatformIO\Flora-ESP8266\Firmware\FLORA_FIRMWARE/VFD_fns.ino line 50
0x40100418: timer1_isr_handler(void*) at C:\Users\Geoffrey\AppData\Local\Arduino15\packages\esp8266\hardware\esp8266\2.7.4\cores\esp8266\core_esp8266_timer.cpp line 36
0x40100460: timer1_isr_handler(void*) at C:\Users\Geoffrey\AppData\Local\Arduino15\packages\esp8266\hardware\esp8266\2.7.4\cores\esp8266\core_esp8266_timer.cpp line 43
0x4010135c: umm_malloc(size_t) at C:\Users\Geoffrey\AppData\Local\Arduino15\packages\esp8266\hardware\esp8266\2.7.4\cores\esp8266\umm_malloc\umm_malloc.cpp line 552
0x4020f4fa: String::toUpperCase() at C:\Users\Geoffrey\AppData\Local\Arduino15\packages\esp8266\hardware\esp8266\2.7.4\cores\esp8266\WString.cpp line 811
0x40101411: umm_realloc(void*, size_t) at C:\Users\Geoffrey\AppData\Local\Arduino15\packages\esp8266\hardware\esp8266\2.7.4\cores\esp8266\umm_malloc\umm_malloc.cpp line 586
0x40100f28: get_poisoned(void*, size_t) at C:\Users\Geoffrey\AppData\Local\Arduino15\packages\esp8266\hardware\esp8266\2.7.4\cores\esp8266\umm_malloc/umm_poison.c line 117
0x40101629: umm_poison_realloc_fl(void*, size_t, char const*, int) at C:\Users\Geoffrey\AppData\Local\Arduino15\packages\esp8266\hardware\esp8266\2.7.4\cores\esp8266\umm_malloc/umm_local.c line 140
0x40100fee: check_poison_neighbors(uint16_t) at C:\Users\Geoffrey\AppData\Local\Arduino15\packages\esp8266\hardware\esp8266\2.7.4\cores\esp8266\umm_malloc/umm_local.c line 59
0x401010f9: umm_malloc_core(size_t) at C:\Users\Geoffrey\AppData\Local\Arduino15\packages\esp8266\hardware\esp8266\2.7.4\cores\esp8266\umm_malloc\umm_malloc.cpp line 458
0x401003e5: __wrap_spi_flash_read(uint32_t, uint32_t*, size_t) at C:\Users\Geoffrey\AppData\Local\Arduino15\packages\esp8266\hardware\esp8266\2.7.4\cores\esp8266\core_esp8266_phy.cpp line 309
0x40100f28: get_poisoned(void*, size_t) at C:\Users\Geoffrey\AppData\Local\Arduino15\packages\esp8266\hardware\esp8266\2.7.4\cores\esp8266\umm_malloc/umm_poison.c line 117
0x402098bf: ESP8266WiFiGenericClass::mode(WiFiMode, WiFiState*) at C:\Users\Geoffrey\AppData\Local\Arduino15\packages\esp8266\hardware\esp8266\2.7.4\libraries\ESP8266WiFi\src\ESP8266WiFiGeneric.cpp line 432
0x4020e549: String::invalidate() at C:\Users\Geoffrey\AppData\Local\Arduino15\packages\esp8266\hardware\esp8266\2.7.4\cores\esp8266\WString.cpp line 140
0x40209e29: ESP8266WiFiGenericClass::mode(WiFiMode, WiFiState*) at C:\Users\Geoffrey\AppData\Local\Arduino15\packages\esp8266\hardware\esp8266\2.7.4\libraries\ESP8266WiFi\src\ESP8266WiFiGeneric.cpp line 468
0x402068a3: startConfigPortal() at C:\Users\Geoffrey\AppData\Local\Arduino15\packages\esp8266\hardware\esp8266\2.7.4\cores\esp8266/WString.h line 230
0x40211875: uart_write(uart_t*, char const*, size_t) at C:\Users\Geoffrey\AppData\Local\Arduino15\packages\esp8266\hardware\esp8266\2.7.4\cores\esp8266\uart.cpp line 509
0x4020cf4c: HardwareSerial::write(unsigned char const*, unsigned int) at C:\Users\Geoffrey\AppData\Local\Arduino15\packages\esp8266\hardware\esp8266\2.7.4\cores\esp8266/HardwareSerial.h line 164
0x4020cf4c: HardwareSerial::write(unsigned char const*, unsigned int) at C:\Users\Geoffrey\AppData\Local\Arduino15\packages\esp8266\hardware\esp8266\2.7.4\cores\esp8266/HardwareSerial.h line 164
0x4020d694: Print::println() at C:\Users\Geoffrey\AppData\Local\Arduino15\packages\esp8266\hardware\esp8266\2.7.4\cores\esp8266\Print.cpp line 186
0x40208670: setup() at C:\Users\Geoffrey\Documents\PlatformIO\Flora-ESP8266\Firmware\FLORA_FIRMWARE/FLORA_FIRMWARE.ino line 267
0x4020f904: loop_wrapper() at C:\Users\Geoffrey\AppData\Local\Arduino15\packages\esp8266\hardware\esp8266\2.7.4\cores\esp8266\core_esp8266_main.cpp line 194
```
Any ideas what this might be?

mcer12, 2021-03-09:
Oh you're correct and sorry I forgot about this... I had to edit the SPI library to support ISR timer. Pull the latest github repository and copy the library to arduino libraries folder. Reopen the sketch and flash it, should work now.

It will give you duplicate SPI library warning but it should correctly take the edited one.

geoffreyheller, 2021-03-10:
The SPI library update seems to have fixed the issue.  Thanks for following up!

mcer12, 2021-03-10:
Great to hear :)

Closed 2021-03-10.

Thread 5 (2021-03-10):

PCB assembly question

geoffreyheller, 2021-03-10:
Would it be possible to include some photos of the assembled PCB in the resources directory?

So for example, I'm not certain of the orientation of the VFD modules (top vs bottom) with respect to the PCB.   It would be very helpful to see a few photos of a completed and working assembly before I go ahead and solder the VFDs in.

Thank you!

mcer12, 2021-03-10:
I've added pcb images, should be clear now :) Also added some notes for tesing voltages.
**IMPORTANT:**
Double and triple check if the headers and usb connector are orented properly! I've made this mistake several times, especially soldering the usb connector backwards :D

geoffreyheller, 2021-03-10:
Thank you!

mcer12, 2021-03-11:
Check out this:
https://github.com/mcer12/Flora-ESP8266/wiki/IV22-Assembly-notes

geoffreyheller, 2021-03-11:
Wow!   Awesome notes.

I did not expect the glass to be so misaligned from the digits.  That's
great to know before I start soldering.
-G.

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

geoffreyheller, 2021-03-11:
I'm still unclear as to which side of the board is the top and which is the
bottom with respect to the IV22 digit orientation.

It would be great if there was an additional photo showing the tubes
attached to the board in such a way that I can see the board orientation
and the decimal points.

Best Regards,
-G.

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

mcer12, 2021-03-11:
That’s easy! Short headers = down, long headers = up :)

čt 11. 3. 2021 v 6:05 odesílatel geoffreyheller <notifications@github.com>
napsal:

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

Closed 2021-03-10.

Thread 8 (2021-03-19):

Daylight savings time incorrect

geoffreyheller, 2021-03-19:
I live in a PDT time zone.  When I enable the Daylight Savings Time checkbox in the config menu my clock reads four hours different from our local time.

I suspect this is the combination:
1) Our normal PST offset is -8h (-480 in the config menu), but we are in PDT so there's a missing hour
2) The TimeChangeRule in FLORA_FIRMWARE is coded to initialize to EDT:
```
TimeChangeRule EDT = {"EDT", Last, Sun, Mar, 1, 120};  //UTC + 2 hours
TimeChangeRule EST = {"EST", Last, Sun, Oct, 1, 60};  //UTC + 1 hours
Timezone TZ(EDT, EST);
```
I suspect that this value is either not getting saved to JSON from the config menu or is not getting loaded properly.

It might also be possible that the Timezone library isn't behaving properly on the ESP8266 arch.  I get the following warning when compiling:

> WARNING: library Timezone claims to run on avr architecture(s) and may be incompatible with your current board which runs on esp8266 architecture(s).

We might want to switch to using the Timezone_Generic library

mcer12, 2021-03-19:
These are just default values, they are ignored. You have to set the timezone in Config portal and dont forget that it's in minutes, not hours ;)

mcer12, 2021-03-19:
Please double check the settings as there might be an error. And if it still doesn't seem to work correctly, please send me a screenshot of your config portal.

geoffreyheller, 2021-03-19:
Here are my timezone and dst settings.   At 11:05am PDT local time I am seeing 7:05 reading out on the clock display.

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

mcer12, 2021-03-19:
Oh it's UTC offset, not relative offset :) So it should be -420, not 60 in this case.

geoffreyheller, 2021-03-19:
Aha!  Yes that did fix it.  Thank you!

Closed 2021-03-19.

Thread 9 (2021-03-19):

Feature Request: LED brightness and pattern control

geoffreyheller, 2021-03-19:
For my v1.0 build I'm getting the entire 5-LED center column pulsing brightly once per second.

It would be nice if I could easily reduce the brightness to match the VFD output.

Also, it would be nice if we could optionally select an LED display pattern that looks more like a colon.   So perhaps three display modes such as:
1) Full column (default)
2) Top two LEDs and bottom two LEDs
3) Second and Fourth LEDs only (odd LEDs)

I'm happy to look into doing this programming if you like.

mcer12, 2021-03-19:
You will likely have to modify the color balance to your version of WS2812. You will have to tinker with the brightness and color balance with the colon plate attached. Feel free to reprogram the colon but since the light will be guided through the colon anyway, I don't see any reason for this ;)

mcer12, 2021-03-19:
You can also turn the colon off in the config portal if it's annoying

geoffreyheller, 2021-03-20:
Ok now that I have 3d printed the case I understand that the colons are a sort of light pipe.  I'm going to try printing them in clear on my SLA printer.

I still think it might be nice to be able to easily customize the color of the colons.  As you say, the color balance might vary between different WS2812's and need adjustment.

mcer12, 2021-03-21:
Yes, I thought of that but since you have to set the color for each brightness setting separately, it would get kinda bloated...

I think it's actually a bit better if you print it with FDM (I used clear PLA), it scatters the light better even when the top is not sanded. If you sand the top, it looks perfect. SLA might actually be too clear.

Closed 2021-03-20.

Thread 14 (2021-05-10):

lowest brightness fluctuation

mcer12, 2021-05-10:
barely visible but still there. WS2812 vs pwm conflict, lets see what can be done about that

mcer12, 2021-05-15:
fixed in 5.1

Closed 2021-05-15.

Thread 22 (2022-07-14):

Change the Darlington Current Driver TD62783A to TD62783AFG or even XL62783

kafisc1, 2022-07-14:
Thank's for this great project. The shortage of parts causes me concern
Do you think it is possible to change from the Darlington Current Driver TD62783A the TD62783AFG or the XL62783?
According to the data-sheets they are all pretty similar. I've attached all data-sheets.
Thank you in advance

[2007301108_HTC-Korea-TAEJIN-Tech-TD62783AD_C699444.pdf](https://github.com/mcer12/Flora-ESP8266/files/9111829/2007301108_HTC-Korea-TAEJIN-Tech-TD62783AD_C699444.pdf)
[2106062005_TOSHIBA-TD62783AFG-O-S-EL_C2762705.pdf](https://github.com/mcer12/Flora-ESP8266/files/9111830/2106062005_TOSHIBA-TD62783AFG-O-S-EL_C2762705.pdf)
[2006031010_XINLUDA-XL62783_C556260.pdf](https://github.com/mcer12/Flora-ESP8266/files/9111847/2006031010_XINLUDA-XL62783_C556260.pdf)

mcer12, 2022-07-14:
If you take a look at the schematic, there's a note about exactly this ;)

Toshiba TBD72783 should be the best option, it's modernized version of the original, little more efficient. XL72783 is a budget alternative. You can also go for the old stock TD62783 on aliexpress, I ordered those from several sellers and they aways worked fine.

Closed 2022-07-21.

Thread 23 (2023-01-12):

How to use nixie IN-12 with VFD IV-22 pcb board?

uongquocthai, 2023-01-12:
How to Use Nixie IN-12 with Flora Esp?
 I see in the attached image it can be used with nixie IN-12. Is the pcb board of the IV-22 compatible with the IN-12? How to fix it if it's not compatible.
Best regards.!
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

mcer12, 2023-01-29:
Hi, check out my project Nick2, it has IN-12 version and it fits in the case.

Closed 2023-01-29.

Thread 25 (2024-04-04):

PCB/Schematic files

harrehlah, 2024-04-04:
Hey mate,

I've been learning and playing around with kicad on my own stuff and now I am wanting to modify your design to take a daughter board to support 3x more IV3s for a temperature display in a new enclosure I have designed - am I able to get a copy of the PCB files? I'm pretty far away skill wise from being able to even replicate your design just yet.

Cheers!

technotrasher, 2024-05-13:
unfortunately the author did not provide pcb Flora-ESP8266
you will have to create the board yourself. the author has errors. It also needs improvement - to connect a time module.
if you have a pcb, could you share?

mcer12, 2024-05-13:
@technotrasher Can you elaborate on the errors?

technotrasher, 2024-05-13:
needs improvement. rare AP7361C-33E-13 - replacement for the common LD1117S33TR. ESP M-2 is a conductor between EN - 10uF - GND. 3.3V is not correct!
in config_portal.ino replace bool startServer() - void startServer(), in FLORA_FIRMWARE.ino remove the unnecessary #include <TimeLib.h>.
NeoPixelBus library is not older than 2.6.6!!!

technotrasher, 2024-05-13:
I also want to add a time module. We have frequent power outages. The watch works fine from the power bank. but there is no Internet access.

harrehlah, 2024-05-14:
> @harrehlah I will add easyeda source for IV3 momentarily, just be aware that you will have to redesign the power supply if you want to drive more tubes. It will probably require USB PD, you won't be able to drive that many tubes from simple 5V USB.

Thanks mate! I appreciate it!

technotrasher, 2024-05-14:
NeoPixelBus by Makuna v. 2.8 - "D:\Flora IV-6\FLORA_FIRMWARE\neopixel_fns.ino: In function 'void updateColonColor(RgbColor)':
D:\Flora IV-6\FLORA_FIRMWARE\neopixel_fns.ino:79:67: error: call of overloaded 'LinearBlend(RgbColor&, RgbColor, double)' is ambiguous
   79 |     colorMed = RgbColor::LinearBlend(color, RgbColor(0, 0, 0), 0.1);
      |                                                                   ^
In file included from c:\Users\technotrasher\Documents\Arduino\libraries\NeoPixelBus_by_Makuna\src/internal/NeoColors.h:34,
                 from c:\Users\technotrasher\Documents\Arduino\libraries\NeoPixelBus_by_Makuna\src/NeoPixelBus.h:38,
                 from D:\Flora IV-6\FLORA_FIRMWARE\FLORA_FIRMWARE.ino:25:"

Thread 26 (2024-11-28):

access point

guus46a, 2024-11-28:
Hello, i have esp12 and wemos programmed, but i get no access point.
Esp12 gives
14:48:07.860 -> load 0x4010f000, len 3584, room 16
14:48:07.860 -> tail 0
14:48:07.860 -> chksum 0xb0
14:48:07.860 -> csum 0xb0
14:48:07.860 -> v2843a5ac
14:48:07.860 -> ~ld
14:48:07.860 ->
14:48:07.860 -> [CONF] Failed to mount file system
14:48:07.860 -> [CONF] Failed to read config file... first run?
14:48:07.860 -> [CONF] Creating new file...
14:48:07.860 -> [CONF] Failed to open config file for writing
14:48:07.860 -> [CONF] No0, len 3584, room 16

in monitor, and wemos givves
14:52:21.959 ->  ets Jan  8 2013,rst cause:2, boot mode:(3,6)
14:52:21.959 ->
14:52:21.959 -> load 0x4010f000, len 3584, room 16
14:52:21.959 -> tail 0
14:52:21.959 -> chksum 0xb0
14:52:21.959 -> csum 0xb0
14:52:21.959 -> v2843a5ac
14:52:21.959 -> ~ld
14:52:22.000 ->
14:52:22.023 -> [CONF] No credentials set, going to config mode.

please help

mcer12, 2024-11-28:
Make sure you select to completely erase flash and also to use version 2.6.x of the esp8266 boards in arduino ide.

guus46a, 2024-11-28:
I have 2.7.4, and try to find 2.6.x but 2.7.4 can not go lower

mcer12, 2024-11-28:
Yes it was 2.7.x sorry :D 2.7.4 is a perfect version to use. Did you follow wiki?
https://github.com/mcer12/Flora-ESP8266/wiki/Firmware-and-flashing

guus46a, 2024-11-28:
I am trying  to change a working clock to get esp on it. That is difficult because it has ds3231, stc programmed ic an an ic i do not know what it is. As i use your bin than i get homepage and can set credentials but after that i can not find page anymore. I have removed the stc ic and found data, sh-cp and st-cp and thought that it should work, but i think there is more going on because vfd's show 888
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

mcer12, 2024-11-28:
Once you connect to wifi, you can only access the config portal via local IP address as mentioned on wiki.
As for trying to botch it onto the other clock, you need to understand the circuit and probably remove the original IC on the board. Just using ESP8266 and my firmware won't work, it will take quite alot of time nad I can't help you with that.

guus46a, 2024-11-28:
I have removed the ic on board and tubes are working with 74hc595n and uln2003. Seconds tube ic has 14 free for data when ic is out and also pin 11 an 12 are connected from all 595's and free when ic is out. Website is now working but tubes still light up as 888.

technotrasher, 2024-12-05:
> I am trying to change a working clock to get esp on it. That is difficult because it has ds3231, stc programmed ic an an ic i do not know what it is. As i use your bin than i get homepage and can set credentials but after that i can not find page anymore. I have removed the stc ic and found data, sh-cp and st-cp and thought that it should work, but i think there is more going on because vfd's show 888 !

I'm working on adding a ds3231 module to my watch. the board is already ready. Now all that remains is to rewrite the program itself. I did this for the watch on NIXIE. and I have ready-made solutions.

guus46a, 2024-12-05:
The only way i could solve my problen is to put an esp sync to ds in the esp and when i want to sync the clock, i put 3.3 volts on esp and clock givves right time.

mcer12, 2025-03-24:
Closing this issue as the further discussion is not really related to this project.

Closed 2025-03-24.
