mcer12/Flora-ESP8266/Firmware/VFD_DIRECT_DRIVE/config_portal.ino

/*
  void toggleConfigMode() {
  if ((batteryPercentage() > 100 || digitalRead(12) == LOW) && buttonWakeUp()) {
    deviceMode = CONFIG_MODE;
    configStartMillis = millis(); // start counter
  }
  }
*/
void startLocalConfigPortal() {
  /*
    if (MDNS.begin("nick")) {
    Serial.println("MDNS responder started");
    }
  */
  httpUpdateServer.setup(&server, update_path, update_username, update_password);
  server.on("/", handleRoot);
  server.begin();
}

void startConfigPortal() {
  configStartMillis = millis(); // start counter

  strip.ClearTo(colorConfigMode);
  strip.Show();

  String ap_name = AP_NAME + macLastThreeSegments(mac);
  IPAddress ap_ip(10, 10, 10, 1);

  WiFi.disconnect();
  WiFi.mode(WIFI_AP);
  WiFi.softAP(ap_name.c_str());
  delay(100);
  WiFi.softAPConfig(ap_ip, ap_ip, IPAddress(255, 255, 255, 0));
  IPAddress ip = WiFi.softAPIP();
  Serial.print("IP address: ");
  Serial.println(ip);
  httpUpdateServer.setup(&server, update_path, update_username, update_password);
  server.on("/", handleRoot);
  server.begin();

  unsigned int lastTest = 0;
  while (deviceMode == CONFIG_MODE) { // BLOCKING INFINITE LOOP

    time_t remainingSeconds = (CONFIG_TIMEOUT - (millis() - configStartMillis)) / 1000;

    if (millis() - configStartMillis > CONFIG_TIMEOUT) {
      WiFi.softAPdisconnect(true);
      //WiFi.mode(WIFI_STA);
      deviceMode = CONNECTION_FAIL;
      //strip.ClearTo(RgbColor(50, 0, 0));
      //strip.Show();
      return;
    }

    if (millis() > lastTest + 100) {
      int splitTime[6] = {
        (hour(remainingSeconds) / 10) % 10,
        hour(remainingSeconds) % 10,
        (minute(remainingSeconds) / 10) % 10,
        minute(remainingSeconds) % 10,
        (second(remainingSeconds) / 10) % 10,
        second(remainingSeconds) % 10,
      };
      for (int i = 0; i < 6; i++) {
        if (i < 4 && splitTime[i] == 0) {
          blankDigit(i);
          continue;
        }
        setDigit(i, splitTime[i]);
      }
      lastTest = millis();
    }

    server.handleClient();
    delay(10);
  }
}

void handleRoot() {
  if (server.args()) {

    // Turn off the nixies
    /*
      ticker.detach();
      digitalWrite(5, 0);
      digitalWrite(4, 0);
    */
    strip.ClearTo(colorConfigSave);
    strip.Show();

    if (server.hasArg("ssid")) {
      json["ssid"] = server.arg("ssid");
    }
    if (server.hasArg("pass") && server.arg("pass") == "placeholder") {
      Serial.println("password is a placeholder, skipped!");
    }
    if (server.hasArg("pass") && server.arg("pass") != "placeholder") {
      json["pass"] = server.arg("pass");
    }
    /*
      if (server.hasArg("ip")) {
      json["ip"] = server.arg("ip");
      }
      if (server.hasArg("gw")) {
      json["gw"] = server.arg("gw");
      }
      if (server.hasArg("sn")) {
      json["sn"] = server.arg("sn");
      }
    */
    if (server.hasArg("t_format")) {
      json["t_format"] = server.arg("t_format");
    }
    if (server.hasArg("zero")) {
      json["zero"] = server.arg("zero");
    }
    if (server.hasArg("bri")) {
      json["bri"] = server.arg("bri");
    }
    if (server.hasArg("nmode")) {
      json["nmode"] = server.arg("nmode");
    }
    if (server.hasArg("cathode")) {
      json["cathode"] = server.arg("cathode");
    }
    if (server.hasArg("rst_cycle")) {
      json["rst_cycle"] = server.arg("rst_cycle");
    }
    if (server.hasArg("rst_ip")) {
      json["rst_ip"] = server.arg("rst_ip");
    }
    if (server.hasArg("std_offset")) {
      json["std_offset"] = server.arg("std_offset");
    }
    if (server.hasArg("dst_enable")) {
      json["dst_enable"] = server.arg("dst_enable");
    } else {
      json["dst_enable"] = 0;
    }
    if (server.hasArg("std_week")) {
      json["std_week"] = server.arg("std_week");
    }
    if (server.hasArg("std_day")) {
      json["std_day"] = server.arg("std_day");
    }
    if (server.hasArg("std_month")) {
      json["std_month"] = server.arg("std_month");
    }
    if (server.hasArg("std_hour")) {
      json["std_hour"] = server.arg("std_hour");
    }
    if (server.hasArg("dst_offset")) {
      json["dst_offset"] = server.arg("dst_offset");
    }
    if (server.hasArg("dst_week")) {
      json["dst_week"] = server.arg("dst_week");
    }
    if (server.hasArg("dst_day")) {
      json["dst_day"] = server.arg("dst_day");
    }
    if (server.hasArg("dst_month")) {
      json["dst_month"] = server.arg("dst_month");
    }
    if (server.hasArg("dst_hour")) {
      json["dst_hour"] = server.arg("dst_hour");
    }
    saveConfig();

  }

  // BLUE THEME FOR VFD String html = "<!DOCTYPE html><html><head><meta charset=\"UTF-8\"><meta name=\"viewport\" content=\"width=device-width,initial-scale=1\"><title>NICK IN-12</title><style>html,body{margin:0;padding:0;font-size:16px;background:#333;}body,*{box-sizing:border-box;font-family:-apple-system,BlinkMacSystemFont,\"Segoe UI\",Roboto,\"Helvetica Neue\",Arial,sans-serif;}a{color:inherit;text-decoration:underline;}.wrapper{padding:30px 0;}.container{margin:auto;padding:40px;max-width:600px;color:#fff;background:#000;box-shadow:0 0 100px rgba(0,0,0,.5);border: 10px solid #444;border-radius:50px;}.row{margin-bottom:15px;}.flexrow{display:flex;justify-items:stretch;align-items:flex-start;flex-wrap:wrap;margin-left:-10px;}.col{width:25%;padding-left:10px;}h1{margin:0 0 10px 0;font-family:Arial,sans-serif;font-weight:300;font-size:2rem;}h1 + p{margin-bottom:30px;}h2{margin:30px 0 0 0;font-family:Arial,sans-serif;font-weight:300;font-size:1.5rem;}h3{font-family:Arial,sans-serif;font-weight:300;font-size:1.2rem;margin: 25px 0 10px 0;}p{font-size:.85rem;margin:0 0 20px 0;color:rgba(255,255,255,.7);}label{display:block;width:100%;margin-bottom:5px;}label+p{margin-bottom:5px;}input[type=\"text\"],input[type=\"number\"],input[type=\"password\"],select{display:inline-block;width:100%;height:42px;line-height:38px;padding:0 20px;color:#fff;border:2px solid #666;background:none;border-radius:5px;transition:.15s;box-shadow:none;outline:none;}input[type=\"text\"]:hover,input[type=\"number\"]:hover,input[type=\"password\"]:hover,select:hover{border-color:#69b6ac;}input[type=\"text\"]:focus,input[type=\"password\"]:focus,select:focus{border-color:#a5fff3;}option{color:#000;}button{display:block;width:100%;padding:10px 20px;font-size:1rem;font-weight:700;text-transform:uppercase;background:#43ffe5;border:0;border-radius:5px;cursor:pointer;transition:.15s;outline:none;}button:hover{background:#a5fff3;}.github{padding:15px;text-align:center;}.github a{color:#43ffe5;transition:.15s;}.github a:hover{color:#a5fff3;}.github p{margin:0;}.mac{display:inline-block;margin-top:8px;padding:2px 5px;color:#fff;background:#444;border-radius:3px;}</style><style media=\"all and (max-width:520px)\">.wrapper{padding:0;}.container{padding:25px 15px;border:0;border-radius:0;}.col{width:50%;}</style></head><body><div class=\"wrapper\">";
  String html = "<!DOCTYPE html><html><head><meta charset=\"UTF-8\"><meta name=\"viewport\" content=\"width=device-width,initial-scale=1\"><title>NICK IN-12</title><style>html,body{margin:0;padding:0;font-size:16px;background:#333;}body,*{box-sizing:border-box;font-family:-apple-system,BlinkMacSystemFont,\"Segoe UI\",Roboto,\"Helvetica Neue\",Arial,sans-serif;}a{color:inherit;text-decoration:underline;}.wrapper{padding:30px 0;}.container{margin:auto;padding:40px;max-width:500px;color:#fff;background:#000;box-shadow:0 0 100px rgba(0,0,0,.5);border: 10px solid #444;border-radius:50px;}.row{margin-bottom:15px;}.flexrow{display:flex;justify-items:stretch;align-items:flex-start;margin-left:-10px;flex-wrap:wrap;}.col{width:25%;padding-left:10px;}h1{margin:0 0 10px 0;font-family:Arial,sans-serif;font-weight:300;font-size:2rem;}h1 + p{margin-bottom:30px;}h2{margin:30px 0 0 0;font-family:Arial,sans-serif;font-weight:300;font-size:1.5rem;}h3{font-family:Arial,sans-serif;font-weight:300;font-size:1.2rem;margin: 25px 0 10px 0;}p{font-size:.85rem;margin:0 0 20px 0;color:rgba(255,255,255,.7);}label{display:block;width:100%;margin-bottom:5px;}label+p{margin-bottom:5px;}input[type=\"text\"],input[type=\"number\"],input[type=\"password\"],select{display:inline-block;width:100%;height:42px;line-height:38px;padding:0 20px;color:#fff;border:2px solid #666;background:none;border-radius:5px;transition:.15s;box-shadow:none;outline:none;}input[type=\"text\"]:hover,input[type=\"number\"]:hover,input[type=\"password\"]:hover,select:hover{border-color:#b1734f;}input[type=\"text\"]:focus,input[type=\"password\"]:focus,select:focus{border-color:#ffb78e;}option{color:#000;}button{display:block;width:100%;padding:10px 20px;font-size:1rem;font-weight:700;text-transform:uppercase;background:#ffa46f;border:0;border-radius:5px;cursor:pointer;transition:.15s;outline:none;}button:hover{background:#ffb78e;}.github{padding:15px;text-align:center;}.github a{color:#ffa46f;transition:.15s;}.github a:hover{color:#ffb78e;}.github p{margin:0;}.mac{display:inline-block;margin-top:8px;padding:2px 5px;color:#fff;background:#444;border-radius:3px;}</style><style media=\"all and (max-width:520px)\">.wrapper{padding:0;}.container{padding:25px 15px;border:0;border-radius:0;}.col{width:50%;}</style></head><body><div class=\"wrapper\">";
  html += "<div class=\"container\"> <form method=\"post\" action=\"/\">";
  html += "<h1>FLORA - Wi-Fi VFD Clock</h1> <p></p>";

  if (deviceMode == CONFIG_MODE) {
    html += "<p>Config AP will automatically shut down after 5 minutes.</p> <p>After you save the settings and connect to wifi, you can open the config portal again using Clock's local IP address.</p>";
  }

  html += "<h2>Network settings</h2> <p>Select your network settings here.</p> <div class=\"row\"> <label for=\"ssid\">WiFi SSID</label> <input type=\"text\" id=\"ssid\" name=\"ssid\" value=\"";
  html += json["ssid"].as<const char*>();
  html += "\"> </div> <div class=\"row\"> <label for=\"pass\">WiFi Password</label> <input type=\"password\" id=\"pass\" name=\"pass\" value=\"";
  const char* pass = json["pass"].as<const char*>();
  if (pass != NULL && pass[0] != '\0') {
    html += "placeholder";
  }
  /*
      html += "\"> </div> <h2>Static IP settings (optional)</h2> <p>Optional settings for static IP, in some cases this might speed up response time. All 3 need to be set and IP should be reserved in router's DHCP settings.";
      html += "<br>MAC address: <span class=\"mac\">";
      html += macToStr(mac);
      html += "</span></p>";
      html += "<div class=\"row\"> <label for=\"ip\">IP Address (optional):</label> <input type=\"text\" id=\"ip\" name=\"ip\" value=\"";
      html += json["ip"].as<const char*>();
      html += "\"> </div> <div class=\"row\"> <label for=\"gw\">Gateway IP (optional):</label> <input type=\"text\" id=\"gw\" name=\"gw\" value=\"";
      html += json["gw"].as<const char*>();
      html += "\"> </div> <div class=\"row\"> <label for=\"sn\">Subnet mask (optional):</label> <input type=\"text\" id=\"sn\" name=\"sn\" value=\"";
      html += json["sn"].as<const char*>();
  */
  html += "\"> </div>";

  html += "<h2>Clock settings</h2><p>Some visual settings and tweaks.</p>";

  html += "<div class=\"row\"><label for=\"t_format\">Time format:</label>";
  html += "<select id=\"t_format\" name=\"t_format\">";
  unsigned int t_format = json["t_format"].as<unsigned int>();
  html += "<option value=\"0\"";
  if (t_format == 0) html += " selected";
  html += ">12-hour</option>";
  html += "<option value=\"1\"";
  if (t_format == 1) html += " selected";
  html += ">24-hour</option>";
  html += "</select></div>";

  html += "<div class=\"row\"><label for=\"zero\">Leading zero:</label>";
  html += "<select id=\"zero\" name=\"zero\">";
  unsigned int zero = json["zero"].as<unsigned int>();
  html += "<option value=\"0\"";
  if (zero == 0) html += " selected";
  html += ">Hide</option>";
  html += "<option value=\"1\"";
  if (zero == 1) html += " selected";
  html += ">Show</option>";
  html += "</select></div>";

  html += "<div class=\"row\"><label for=\"bri\">Brightness:</label>";
  html += "<select id=\"bri\" name=\"bri\">";
  unsigned int bri = json["bri"].as<unsigned int>();
  html += "<option value=\"0\"";
  if (bri == 0) html += " selected";
  html += ">Low</option>";
  html += "<option value=\"1\"";
  if (bri == 1) html += " selected";
  html += ">Medium</option>";
  html += "<option value=\"2\"";
  if (bri == 2) html += " selected";
  html += ">High</option>";
  html += "</select></div>";

  html += "<div class=\"row\"><label for=\"nmode\">Night mode:</label>";
  html += "<select id=\"nmode\" name=\"nmode\">";
  unsigned int nmode = json["nmode"].as<unsigned int>();
  html += "<option value=\"0\"";
  if (nmode == 0) html += " selected";
  html += ">None</option>";
  html += "<option value=\"1\"";
  if (nmode == 1) html += " selected";
  html += ">Set low brightness between 22:00-06:00</option>";
  //html += "<option value=\"2\"";
  //if (nmode == 2) html += " selected";
  //html += ">Clock OFF between 22:00-06:00</option>";
  html += "</select></div>";

  html += "<div class=\"row\"><label for=\"cathode\">Cathode poisoning prevention:</label>";
  html += "<select id=\"cathode\" name=\"cathode\">";
  unsigned int cathode = json["cathode"].as<unsigned int>();
  html += "<option value=\"0\"";
  if (cathode == 0) html += " selected";
  html += ">None</option>";
  html += "<option value=\"1\"";
  if (cathode == 1) html += " selected";
  html += ">10min cycle every hour between 2-6 AM</option>";
  html += "<option value=\"2\"";
  if (cathode == 2) html += " selected";
  html += ">10min cycle every hour between 2-6 AM + 60s cycle every hour (recommended)</option>";
  html += "</select></div>";

  html += "<div class=\"row\"><label for=\"rst_cycle\">Cycle through digits after every reset:</label>";
  html += "<select id=\"rst_cycle\" name=\"rst_cycle\">";
  unsigned int rst_cycle = json["rst_cycle"].as<unsigned int>();
  html += "<option value=\"0\"";
  if (rst_cycle == 0) html += " selected";
  html += ">No</option>";
  html += "<option value=\"1\"";
  if (rst_cycle == 1) html += " selected";
  html += ">Yes (good for testing all digits)</option>";
  html += "</select></div>";

  html += "<div class=\"row\"><label for=\"rst_ip\">Show IP address after reset (last 3 digits):</label>";
  html += "<select id=\"rst_ip\" name=\"rst_ip\">";
  unsigned int rst_ip = json["rst_ip"].as<unsigned int>();
  html += "<option value=\"0\"";
  if (rst_ip == 0) html += " selected";
  html += ">No</option>";
  html += "<option value=\"1\"";
  if (rst_ip == 1) html += " selected";
  html += ">Yes</option>";
  html += "</select></div>";


  html += "<h2>Time settings</h2>";
  html += "<p>Set your timezone and optionally also daylight saving.</p>";

  html += "<div class=\"row\"><label for=\"std_offset\">UTC offset (in minutes, -660 = -11h, 660 = +11h):</label>";
  html += "<input type=\"number\" id=\"std_offset\" name=\"std_offset\" min=\"-660\" max=\"660\" value=\"";
  html += json["std_offset"].as<const char*>();
  html += "\"></div>";

  html += "<div class=\"row\"><label for=\"dst_enable\">";
  html += "<input type=\"checkbox\" id=\"dst_enable\" name=\"dst_enable\" value=\"1\" onClick=\"JavaScript:toggleVisibility(this,'dst_wrapper');\"";
  if (json["dst_enable"].as<int>() == 1) {
    html += " checked=\"checked\"";
  }
  html += "> Enable Daylight Saving (summer time)</label></div>";
  html += "<p>When enabled, additional fields will pop up for you to set daylight saving time. <a href=\"https://www.timeanddate.com/time/zone/uk/london\" target=\"_blank\">You can search for your timezone here</a></p>";
  //dst_wrapper






  html += "<div id=\"dst_wrapper\">"; // WRAPPER START

  html += "<h3>Standard (winter) time starts at:</h3>";

  html += "<div class=\"flexrow\">"; // FLEX ROW START

  html += "<div class=\"col\">"; // COLUMN START
  html += "<div class=\"row\"><label for=\"std_week\">Week:</label>";
  html += "<select id=\"std_week\" name=\"std_week\">";
  unsigned int std_week = json["std_week"].as<unsigned int>();
  html += "<option value=\"0\"";
  if (std_week == 0) html += " selected";
  html += ">Last</option>";
  html += "<option value=\"1\"";
  if (std_week == 1) html += " selected";
  html += ">First</option>";
  html += "<option value=\"2\"";
  if (std_week == 2) html += " selected";
  html += ">Second</option>";
  html += "<option value=\"3\"";
  if (std_week == 3) html += " selected";
  html += ">Third</option>";
  html += "<option value=\"4\"";
  if (std_week == 4) html += " selected";
  html += ">Fourth</option>";
  html += "</select></div>";
  html += "</div>"; // COLUMN END

  html += "<div class=\"col\">"; // COLUMN START
  html += "<div class=\"row\"><label for=\"std_day\">Day:</label>";
  html += "<select id=\"std_day\" name=\"std_day\">";
  unsigned int std_day = json["std_day"].as<unsigned int>();
  html += "<option value=\"1\"";
  if (std_day == 1) html += " selected";
  html += ">Sun</option>";
  html += "<option value=\"2\"";
  if (std_day == 2) html += " selected";
  html += ">Mon</option>";
  html += "<option value=\"3\"";
  if (std_day == 3) html += " selected";
  html += ">Tue</option>";
  html += "<option value=\"4\"";
  if (std_day == 4) html += " selected";
  html += ">Wed</option>";
  html += "<option value=\"5\"";
  if (std_day == 5) html += " selected";
  html += ">Thu</option>";
  html += "<option value=\"6\"";
  if (std_day == 6) html += " selected";
  html += ">Fri</option>";
  html += "<option value=\"7\"";
  if (std_day == 7) html += " selected";
  html += ">Sat</option>";
  html += "</select></div>";
  html += "</div>"; // COLUMN END

  html += "<div class=\"col\">"; // COLUMN START
  html += "<div class=\"row\"><label for=\"std_month\">Month:</label>";
  html += "<select id=\"std_month\" name=\"std_month\">";
  unsigned int std_month = json["std_month"].as<unsigned int>();
  html += "<option value=\"1\"";
  if (std_month == 1) html += " selected";
  html += ">Jan</option>";
  html += "<option value=\"2\"";
  if (std_month == 2) html += " selected";
  html += ">Feb</option>";
  html += "<option value=\"3\"";
  if (std_month == 3) html += " selected";
  html += ">Mar</option>";
  html += "<option value=\"4\"";
  if (std_month == 4) html += " selected";
  html += ">Apr</option>";
  html += "<option value=\"5\"";
  if (std_month == 5) html += " selected";
  html += ">May</option>";
  html += "<option value=\"6\"";
  if (std_month == 6) html += " selected";
  html += ">Jun</option>";
  html += "<option value=\"7\"";
  if (std_month == 7) html += " selected";
  html += ">Jul</option>";
  html += "<option value=\"8\"";
  if (std_month == 8) html += " selected";
  html += ">Aug</option>";
  html += "<option value=\"9\"";
  if (std_month == 9) html += " selected";
  html += ">Sep</option>";
  html += "<option value=\"10\"";
  if (std_month == 10) html += " selected";
  html += ">Oct</option>";
  html += "<option value=\"11\"";
  if (std_month == 11) html += " selected";
  html += ">Nov</option>";
  html += "<option value=\"12\"";
  if (std_month == 12) html += " selected";
  html += ">Dec</option>";
  html += "</select></div>";
  html += "</div>"; // COLUMN END

  html += "<div class=\"col\">"; // COLUMN START
  html += "<div class=\"row\"><label for=\"std_hour\">Hour:</label>";
  html += "<input type=\"number\" id=\"std_hour\" name=\"std_hour\" min=\"0\" max=\"23\" value=\"";
  html += json["std_hour"].as<const char*>();
  html += "\"></div>";
  html += "</div>"; // COLUMN END

  html += "</div>"; // FLEX ROW END







  html += "<h3>Daylight saving (summer) time starts at:</h3>";

  html += "<div class=\"flexrow\">"; // FLEX ROW START

  html += "<div class=\"col\">"; // COLUMN START
  html += "<div class=\"row\"><label for=\"dst_week\">Week:</label>";
  html += "<select id=\"dst_week\" name=\"dst_week\">";
  unsigned int dst_week = json["dst_week"].as<unsigned int>();
  html += "<option value=\"0\"";
  if (dst_week == 0) html += " selected";
  html += ">Last</option>";
  html += "<option value=\"1\"";
  if (dst_week == 1) html += " selected";
  html += ">First</option>";
  html += "<option value=\"2\"";
  if (dst_week == 2) html += " selected";
  html += ">Second</option>";
  html += "<option value=\"3\"";
  if (dst_week == 3) html += " selected";
  html += ">Third</option>";
  html += "<option value=\"4\"";
  if (dst_week == 4) html += " selected";
  html += ">Fourth</option>";
  html += "</select></div>";
  html += "</div>"; // COLUMN END

  html += "<div class=\"col\">"; // COLUMN START
  html += "<div class=\"row\"><label for=\"dst_day\">Day:</label>";
  html += "<select id=\"dst_day\" name=\"dst_day\">";
  unsigned int dst_day = json["dst_day"].as<unsigned int>();
  html += "<option value=\"1\"";
  if (dst_day == 1) html += " selected";
  html += ">Sun</option>";
  html += "<option value=\"2\"";
  if (dst_day == 2) html += " selected";
  html += ">Mon</option>";
  html += "<option value=\"3\"";
  if (dst_day == 3) html += " selected";
  html += ">Tue</option>";
  html += "<option value=\"4\"";
  if (dst_day == 4) html += " selected";
  html += ">Wed</option>";
  html += "<option value=\"5\"";
  if (dst_day == 5) html += " selected";
  html += ">Thu</option>";
  html += "<option value=\"6\"";
  if (dst_day == 6) html += " selected";
  html += ">Fri</option>";
  html += "<option value=\"7\"";
  if (dst_day == 7) html += " selected";
  html += ">Sat</option>";
  html += "</select></div>";
  html += "</div>"; // COLUMN END

  html += "<div class=\"col\">"; // COLUMN START
  html += "<div class=\"row\"><label for=\"dst_month\">Month:</label>";
  html += "<select id=\"dst_month\" name=\"dst_month\">";
  unsigned int dst_month = json["dst_month"].as<unsigned int>();
  html += "<option value=\"1\"";
  if (dst_month == 1) html += " selected";
  html += ">Jan</option>";
  html += "<option value=\"2\"";
  if (dst_month == 2) html += " selected";
  html += ">Feb</option>";
  html += "<option value=\"3\"";
  if (dst_month == 3) html += " selected";
  html += ">Mar</option>";
  html += "<option value=\"4\"";
  if (dst_month == 4) html += " selected";
  html += ">Apr</option>";
  html += "<option value=\"5\"";
  if (dst_month == 5) html += " selected";
  html += ">May</option>";
  html += "<option value=\"6\"";
  if (dst_month == 6) html += " selected";
  html += ">Jun</option>";
  html += "<option value=\"7\"";
  if (dst_month == 7) html += " selected";
  html += ">Jul</option>";
  html += "<option value=\"8\"";
  if (dst_month == 8) html += " selected";
  html += ">Aug</option>";
  html += "<option value=\"9\"";
  if (dst_month == 9) html += " selected";
  html += ">Sep</option>";
  html += "<option value=\"10\"";
  if (dst_month == 10) html += " selected";
  html += ">Oct</option>";
  html += "<option value=\"11\"";
  if (dst_month == 11) html += " selected";
  html += ">Nov</option>";
  html += "<option value=\"12\"";
  if (dst_month == 12) html += " selected";
  html += ">Dec</option>";
  html += "</select></div>";
  html += "</div>"; // COLUMN END

  html += "<div class=\"col\">"; // COLUMN START
  html += "<div class=\"row\"><label for=\"dst_hour\">Hour:</label>";
  html += "<input type=\"number\" id=\"dst_hour\" name=\"dst_hour\" min=\"0\" max=\"23\" value=\"";
  html += json["dst_hour"].as<const char*>();
  html += "\"></div>";
  html += "</div>"; // COLUMN END

  html += "</div>"; // FLEX ROW END

  html += "<div class=\"row\"><label for=\"dst_offset\">Daylight saving (summer) time UTC offset (in minutes):</label>";
  html += "<input type=\"number\" id=\"dst_offset\" name=\"dst_offset\" min=\"-660\" max=\"660\" value=\"";
  html += json["dst_offset"].as<const char*>();
  html += "\"></div>";

  html += "</div>"; // WRAPPER END







  html += "<div class=\"row\"><button type=\"submit\">Save and reboot</button></div></form></div>";
  html += "<div class=\"github\"><p>";
  html += FW_NAME;
  html += " ";
  html += FW_VERSION;
  html += ", check out <a href=\"https://github.com/mcer12/Flora-ESP8266\" target=\"_blank\"><strong>NICK</strong> on GitHub</a></p> </div>";
  html += "</div>";
  html += "<script>function toggleVisibility(eventsender, idOfObjectToToggle){var myNewState = \"none\";if (eventsender.checked === true){myNewState = \"block\";}document.getElementById(idOfObjectToToggle).style.display = myNewState;}toggleVisibility(document.getElementById('dst_enable'), 'dst_wrapper');</script>";
  html += "</body> </html>";
  server.send(200, "text/html", html);

  if (server.args()) {
    // Save data
    delay(1000);
    saveConfig();

    ESP.restart();
    delay(100);
  }
}
