mcer12/Flora-ESP8266/(commit log)

2020-12-22 BOM + schematic
    [BOM_VFD_CLOCK_IV6.csv]
2020-12-22 one firmware using Timer for pwm (can stutter when wifi is receiving) and one experimental using HW interrupts and SPI (seems to be working, needs work to prevent WS2812 glitches)
    [NDP_fns.ino, NDP_setup.ino, VFD_DIRECT_DRIVE.ino, VFD_DIRECT_DRIVE_EXPERIMENTAL.ino, VFD_fns.ino, config_portal.ino, fns.ino, neopixel_fns.ino]
2021-01-30 BOM + gerbers
    [IV-22_BOM.csv, IV-6_BOM.csv]
2021-02-10 IV-22 schematic update
2021-02-10 IV-22 BOM update
    [IV-22_BOM.csv]
2021-03-09 Modified SPI library for use with ISR
2021-03-10 pcb images
2021-03-10 IV-22 V2 resources
    [IV-22_BOM.csv, IV-22_V1_BOM.xlsx, IV-22_V2_BOM.xlsx]
2021-03-11 BOM update
    [IV-22_V2_BOM.xlsx]
2021-03-14 IV-12 support, IV-12 schematic, some fw fixes
    [FLORA_FIRMWARE.ino, VFD_fns.ino, config_portal.ino]
2021-03-14 IV-12 schematic
2021-03-18 PWM phase shift to smoothen pwm
2021-03-19 Updates using GET request don't require reset anymore.
    [FLORA_FIRMWARE.ino, VFD_fns.ino, config_portal.ino]
2021-04-16 IV-6 gerber, minor fw edits
    [IV-6_BOM.csv]
2021-04-30 V2 silkscreen version fix, pick & place file added
    [IV-22_V2_pickandplace.csv]
2021-05-10 Connecting animation glitch fixed
    [FLORA_FIRMWARE.ino, VFD_fns.ino]
2021-05-15 colon colorpicker, config portal facelift, bunch of changes and fixes. Version bump to 5.0
    [FLORA_FIRMWARE.ino, VFD_fns.ino, config_portal.ino, neopixel_fns.ino]
2021-05-15 minor visual edits to the config portal, several bugfixes
    [FLORA_FIRMWARE.ino, VFD_fns.ino, config_portal.ino, neopixel_fns.ino]
2021-05-28 removed old IV22 V1 resources
    [IV-22_V1_BOM.xlsx]
2021-05-28 IV-12 BOM, gerber and schematic added.
    [IV-12_BOM.xlsx]
2021-06-12 fixed missing zero when showing IP address
    [VFD_fns.ino]
2021-06-20 fixed millis rollover, added support for IV12 clock, added copyright claims, version bump
    [FLORA_FIRMWARE.ino, config_portal.ino, neopixel_fns.ino]
2021-06-26 Added image to IV22 assembly notes
2021-08-25 jlcpcb pick & place added
    [IV-12_pickandplace.csv, IV-6_pickandplace.csv]
2023-05-03 IV-6 V2 added, version bump
    [IV-6_V2_BOM.csv, IV-6_V2_pickandplace.csv]
2023-05-03 Fixed IV-6 V2 pinout
    [FLORA_FIRMWARE.ino]
2023-05-03 added IV3 version, fixed IV6 V2 BOM
    [IV-3_BOM.csv, IV-3_pickandplace.csv, IV-6_V2_BOM.csv]
2023-05-10 Fixed bom for IV-3 & IV-6 clocks
    [IV-3_BOM.csv, IV-6_V2_BOM.csv]
